manthan1412/air_touch/Schematic Design/Schematic Design link.txt

Website: http://www.schematics.com/editor/kd-46027/
Credential : google account
last Updated : 5/18/2017
