manthan1412/air_touch/Report/abreviatinos.docx

LIST OF ABBREVIATIONS

IMU | Inertial Measurement Unit
AIRtouch | Artificial, Intelligent Remote touch keyboard
USB | Universal Serial Bus
MSP430 | Mixed Signal Processor 430
FSR | Force Sensitive Resister
PCB | Printed Circuit Board
UART | Universal Asynchronous Receive Transmit protocol
PWM | Pulse Width Modulation
TL | Left Thumb
TR | Right Thumb
PLX-DAQ | Parallax Data Acquisition Tool
COM | Communication
CSV | Comma Separated Values
RTC | Real Time Clock
I/O | Input and Output
ASCII | American Standard Code for Information Interchange
RI | Right hand Index finger
RM | Right hand Middle finger
RR | Right hand Ring dinger
RL | Right hand Little finger
LI | Left hand Index finger
LM | Left hand Middle finger
LR | Left hand Ring finger
LL | Left hand Little finger
UL | Upper Layer
ML | Middle Layer
LL | Lower Layer
