manthan1412/air_touch/airType_wordlist.txt

fawn
nunnery
gag
woods
cxsar
spiders
hanging
woody
offendeth
comically
beadsmen
canes
scold
e_
mustachio
mutinies
alphabetic
benvolio
fyodor
slothful
_facilitate_
appropriation
strictest
bringing
wooded
wooden
wednesday
steadfastness
sooty
inevitably
covechous
shock_
sooth
275
sustaining
consenting
279
kodak
snuggled
inanimate
nonsense
errors
cooking
hp
paphos
designing
razeth
shocks
crouch
chins
disobeying
siward
sunbeams
perforations
affiliates
chine
47
perfunctorily
china
affiliated
klausenburgh
boblibindo
natured
kids
climbed
controversy
natures
climber
stringless
ycleped
golden
projection
lengthen
garter
stern
homespuns
nightwork
sternest
dna
catchy
vicegerent
music
therefore
dns
vulcanized
reasserting
swoopstake
sermons
populations
circumstanced
yahoo
primeval
schoolboys
unpack
circumstances
intake
locked
isidore
tinkle
wand
wane
unjust
wann
reignier
disparagement
titanium
callin
want
cookery
absolute
carous
travel
fetters
playback
saskatchewan
canaries
cadence
orspital
halloing
_astronomical_
wrong
sedg
twined
crooking
domed
wronk
gardon
misgives
_immortalize_
welcomed
puling
rewarder
whizzing
_devoid_
rewarded
welcomer
welcomes
fir
wickedly
fit
raggedness
fix
mayst
anticipations
fig
fie
wales
fin
bankrupts
fil
guiled
ostents
corridor
unpeg
vouchers
twits
medline
effects
_verbatim_
sixteen
undeveloped
glutted
troublous
pigrogromitus
bewept
arrow
uninfluenced
_reflection_
burial
telescope
unshak
allah
childer
allan
phoenicians
parasites
currencies
allay
toleration
indiscretion
brutish
gradation
mason
unclog
encourage
adapt
smithfield
outburst
nightdress
strato
abbots
underfoot
strata
corrects
estimate
universally
silent
sys
connive
receipted
ministries
disturbed
portmanteau
whipster
lightened
disfigured
emaciated
reciprocally
maladies
clamorous
olds
revania
service
needer
needed
master
predecessors
genesis
rewards
razorable
enthrall
exulted
cisterns
tokay
swish
mutilated
positively
asaph
idly
regulator
idle
sheen
feeling
longs
politely
spectrum
targe
dozed
erbear
dozen
affairs
wholesome
mostly
hymen
uncouth
toothed
mickle
shipments
committing
diminishing
vexing
venial
mouth
reverence
fluster
expound
singer
singes
unpleas
nettle
affirmatives
tech
purged
saying
tempter
padded
fennel
ulcer
loiterer
tempted
cheaply
apace
clicked
kerns
extemporal
kinase
neighs
rico
blist
bliss
rick
rich
rice
rica
plate
remotest
_absolutely_
guileful
clumsiness
altogether
affronted
givest
uncleanliness
wishtly
jaguar
nicely
patch
eyelids
boarded
unspoke
clarified
sensitivity
norways
advisedly
lots
irs
lott
xvi
droven
exhalation
ira
irc
ire
requisites
discipline
extend
nature
meddlin
lapping
embracement
extent
accessed
tyranny
sparta
heating
incense
perigouna
lookin
southeastern
mortified
assur
gypsies
cult
charnel
humming
assum
godhead
_style_
union
fri
fro
studious
finsbury
muck
much
chink
fry
tallest
cub
retrospect
spit
freehold
davy
dave
doubts
spin
skilfully
misconstrues
administrative
contingencies
crupper
employ
divineness
groats
superserviceable
ternate
prostrate
reunion
overta
verges
ield
disprov
jacksauce
eighteen
principal_
bricklayer
memorial
malefactors
honi
split
visitations
freeness
supped
boiled
marches
frenchmen
qualifications
workforce
sicilians
consents
boiler
supper
untirable
dolabella
canzonet
peremptory
academic
stillness
euphronius
1672
corporate
bellow
maketh
outlives
prognosticate
brandish
endue
hal
ham
trinculo
had
advancement
hag
hay
beloved
endur
hap
has
hat
preciously
municipal
elders
confection
online
continuantly
clustered
shadow
flotsam
joineth
boundeth
nicaria
asmath
alice
festivities
unreprievable
gads
effusion
attorney
disks
crowd
czech
scathe
crown
postmaster
captive
tooked
perchance
repudiating
bottom
inhuman
plucked
appletart
plucker
yelpin
pharaoh
considerin
herrin
starring
filaments
disdains
obsque
stoker
bencher
benches
aden
marshall
bullcalf
bulgar
administer
beings
swelter
shoots
despised
fabric
suffice
boileau
tame
grasping
despises
despiser
greatness
rapes
contusions
alexandrian
ubique
perfumer
perfumes
waistcoat
thesaurus
cumea
verde
perfumed
safeguard
congratulations
humbled
rippling
changelessness
humbler
humbles
nicest
soldering
duer
dues
passenger
disgrace
marullus
extenuated
unnerve
extenuates
moderns
leviathans
signification
paperwork
sympathy
supplier
tasimeter
crowns
role
tamely
vegetative
roll
hawken
intend
palms
palmy
transported
comely
intent
smelling
variable
gamboys
overturned
gown
cincinnati
chain
whoever
machination
osr
ost
osw
coude
chair
irrecoverable
entendre
ballet
impressive
grapples
freelance
crates
crater
oversight
tenacious
downloading
olympus
choice
metamorphoses
embark
gloomy
stays
glooms
pranced
exact
minute
hipparchus
cooks
reining
islets
continuate
shylock
unmix
meadow
hindered
lengthened
chopping
shirts
adorns
kindliness
headset
antwerp
celebrated
300
geography
celebrates
drafted
climbs
honour
plucking
addrest
address
dwindling
convertite
blunter
enroll
reciterai
fledge
dusty
cette
packthread
queue
accomplished
influx
abash
betraying
eglantine
abase
undergone
opposer
working
untaught
hcl_
ergalled
sisterly
vigour
opposed
pavilions
dampness
roland
ittin
approving
thompson
consoles
avaunt
riders
moulten
originally
abortion
harmonious
following
admired
mirrors
locks
outhouses
rivage
admirer
fosset
feof
listens
charneco
vainly
haarlem
thanking
nicanor
kneller
meddler
behowls
questrists
ossian
brainless
egotistical
temperate
surfing
mangy
conscious
puller
pullet
thunders
mango
auger
skirmish
wolves
pulled
salmons
quarreller
feedin
webpage
years
professors
yearn
calydon
quarrelled
jig
unprizable
infirmities
jim
troubles
troubler
horsebacking
antipathy
suspension
troubled
rousillon
apron
_your
recipients
civilian
murrion
bashful
courageously
indigenous
overpowering
drilling
sorted
plung
deads
dido
didn
_you_
azote
fisherman
quarter
seldom
clack
retrieve
bursting
amamon
presages
receipt
frames
irremediable
entering
salads
disasters
learnings
unsaleable
presageth
_archbishop_
seriously
trauma
subtile
internet
macedon
plotting
curbs
incentives
revengingly
inwardly
ontario
deliver
byte
thatching
workmanship
modest
initiate
marls
hames
aboard
stableness
marly
draggin
subduements
neglect
emotion
saving
spoken
reprisal
one
erparted
ony
spokes
ons
affords
stifles
penitence
stifled
embalming
lingering
shawl
surges
tombstones
snatch
herds
absorbs
eneid
rehab
unburied
_compacted_
wandering
illness
sumptuous
turned
locations
jewels
balsam
uninterrupted
_crater_
turner
borough
erudition
invite
betideth
baggage
warriors
sankar
unsquar
zoo
intends
portents
europeans
printer
opposite
buffer
discerning
buffet
staineth
printed
sainted
knowingly
huns
swingers
etruria
lydia
jewry
fascinated
buriest
sovereignest
delphos
friction
counterpoints
heeding
aggressive
imagined
unpractical
intelligencing
hindmost
guarded
rejoiced
tilting
_aigre_
rejoices
awaiting
perspicacity
pickers
keenly
epistles
seeting
recurred
carrion
recoiling
tike
vision
mountant
enthralled
audaciously
whoremasterly
undescried
impressions
hastened
bodiless
refreshes
dexter
impartment
alarming
avails
dismemberment
moons
satiety
enjoys
playhouse
garde
distrain
marrowless
annexing
punto
braggarts
awards
distrait
concentrated
circumference
majestically
penitently
hearsed
rhodes
1720
paring
s
goodliest
candlestick
expended
recordings
allowance
compels
glutinous
_cornishman_
gaiety
compell
_steer_
buoyancy
practiser
practises
webshots
leander
west
practised
motives
challis
wants
vomits
formed
readings
photos
tightened
abject
extant
former
runnin
scath
scarlet
pretence
provost
squeezes
butchers
nutritional
squeezed
situation
scatt
penthouse
mutineers
engaged
organizational
limping
nevils
ascii
verified
pothecary
gelding
inscrib
wires
edged
assigns
sickness
defy
warkworth
edges
wired
advertisement
_aqueous_
vitement
shelterless
nothin
dimension
persistently
adoring
being
disconcert
interrupt
steamer
rover
plumbing
grounded
kirk
dicke
plumed
dicky
overthrow
plumes
dicks
rejoic
unhopefullest
unerring
decomposed
sums
unveil
gestures
summ
traffic
preference
world
postal
decomposes
tremulous
barbermonger
superiority
mienne
militate
unprofited
tombed
obstruct
satisfactory
superintendent
grub
tvs
grup
forehand
diving
divine
saidst
perdie
cavity
overscutch
seaman
measurin
purfleet
restoring
wolds
squabble
averse
leadership
thailand
prepared
hopkins
unmannerly
disabilities
blabs
bewet
_magnetic_
frights
johnston
blabb
perturbed
commingled
speargrass
antidote
ineffably
ineffable
lively
pivot
mongers
rumbled
gleam
glean
mindless
sealed
brazilian
punished
bubble
_anything_
continents
wits
conclud
polnevas
foreheads
witb
with
abused
pull
rush
ragg
rage
tripe
rags
hooal
dirty
abuser
abuses
trips
rust
neglectingly
bedabbled
watches
watcher
ensuing
mutineer
watched
tremble
childed
cream
sayest
yoga
cooked
ascertained
sympathetically
puppy
1449
indemnify
razing
alban
waving
intimation
brotherhood
infirmity
thorn
evenin
maliciously
dissentious
dyed
thort
initiating
dyer
curate
consciences
chimurcho
caused
beware
ceramic
ersized
importune
petherick
hyrcanian
conceitless
oaths
unsever
riots
countless
midwest
carters
norm
roadway
wayfarers
floated
burgher
24th
rn
sans
ascendeth
sang
sand
sane
small
sank
abbreviated
quicker
199
198
195
194
197
196
pash
tirest
193
healed
past
cuckoldly
burnish
stamping
irreconcil
displays
pass
amplified
quicken
clock
corked
knaws
prevailed
gouty
dracula
gouts
jurist
hewing
dwells
hasn
full
hash
editorial
gregory
diapers
daunted
hast
november
rembrandt
cordelia
experience
mouldy
prior
periodic
cessation
moulds
suave
followed
adidas
reclaimed
uprise
follower
pliny
berwick
coadjutor
silva
attendance
mort
mori
morn
fragrance
graveside
more
door
masculine
initiated
tester
company
corrected
chucks
tested
lameness
doom
leary
vailed
cushes
thickest
knocker
learn
knocked
bogs
meaner
fartuous
cabileros
pulpits
prostration
bonded
huge
respective
hugg
hens
viand
hugh
enlarge
dismissed
unhurt
dotard
hugs
erboard
sprinkle
intended
mender
thickened
disgraced
sympathize
mistempered
mended
maltese
lanka
disgraces
malevolent
_incense_
resemble
twisting
rosebud
basilisco
protestation
bailey
exclusions
replied
wools
uncurse
installed
stylus
resorts
_there
paper
scott
replies
smiling
cheerfulness
roots
saucy
tantalizingly
stricture
hounds
symptoms
shuddering
isaac
sauce
colleague
clefts
gipsy
diffusest
jamrach
weeds
idols
smalus
barefaced
weedy
coursed
denny
courser
courses
sovereignly
piping
shocking
reactions
engendered
begged
numeric
gioucestershire
treasonable
lanthorn
advertisers
operation
slish
impudency
shepherdess
dowsabel
kensington
research
inquirer
denoted
offline
impudence
bedlam
parings
abnormally
awin
daguerre
definition
pairs
constraineth
testament
unblown
purport
brutally
preservation
sequester
narcissus
scuffling
tristful
aven
arlington
cradles
moderately
hallowed
bedridden
saint
benedick
aves
essays
ilium
cradled
peaceably
justly
ainsi
capilet
unlesson
ungrateful
condolences
perfum
dikes
spectatorship
blyme
trevorrick
emirates
graveless
charger
elaborate
inferreth
navigators
insertion
organisations
waft
guarding
jumpeth
servitude
bewasted
blond
odors
veronesa
_knew_
sell
sharps
fermented
seld
extorted
self
also
recognizing
permanency
butterflies
astrea
immeasurable
mends
departmental
singles
coordinate
virus
blunting
outlustres
singled
understands
omaha
seize
sometimes
discomforts
barred
reeleth
barren
recks
barrel
bulletin
ambiguities
planched
exterminate
blended
accommodations
bookings
ascanius
baneful
affin
occupation
indifferency
wrapp
wraps
wrapt
collop
cassette
dilatoriness
removable
protectorship
indifference
columns
lombard
ceasing
sunny
remedy
twill
compass
distraction
devoured
sects
pleasures
bytes
sojourn
goitre
wrecks
storming
insane
delicately
313
activists
unplausive
overboard
presenteth
analog
shower
fullin
thrive
aspicious
untouched
demoniac
deracinate
tion
lass
last
anacreon
opal
connection
unthinking
neanmoins
lash
bell
acted
possets
thrasonical
provok
hetman
belt
surance
subversion
finless
satire
suburbs
proprietor
extravagant
patrolled
gloating
combatants
infect
mildness
moderation
awake
struck
presses
presser
caged
newcastle
budger
budget
admire
33
pressed
_transparent_
31
brawny
lade
agitation
vol
von
binding
vot
vow
vor
wouid
vox
cuisine
starlight
twitchy
erbeat
calculation
waddled
unbashful
flooded
mongrels
nickname
implement
infamous
controlment
mered
clime
belee
recoverable
accusative
sequest
crackled
salve
suffolk
hercules
spinners
christendom
cuffs
lady
andorra
rangers
parents
indonesian
emergency
couple
affaire
wives
abound
wived
unwearied
spine
unbowed
spina
chorus
wildcats
tribes
turvy
methods
acknowledg
unsubstantial
bounce
greener
nereides
novelty
benefit
behave
cygnets
obscures
uncropped
feelings
respite
obscured
novices
deserved
simplify
wrinkles
deserver
deserves
solinus
wrinkled
sepulture
terrorists
intl
noddle
vizaments
contributor
sleepest
chirping
katie
spak
span
harnessed
tasting
gases
bios
smilets
sheepcotes
spar
redoubled
opens
considerably
jacks
hawaiian
solaris
atlantic
carping
stillest
jacka
stigmatic
considerable
intestines
peeped
charmed
_indented_
frush
eddie
maturity
charmer
awestruck
chaf
chad
inkjet
unsafe
haunt
cham
char
chas
chap
diverse
chaw
chat
surveying
engender
idleness
mattock
conceptions
fumitory
revision
livings
sublimation
bianca
perverse
bianco
lang
lane
land
lanc
wafer
lank
scream
fidelicet
beverage
prizer
dawning
treasuries
inkhorn
broaden
agued
unbuttoning
broader
amiss
conservative
agues
amalgamation
lecon
turkish
horsing
narbon
contours
debarred
expeditious
carelessly
indicating
deficit
uploaded
scanter
fingres
scanted
petitions
decorating
minerals
championship
_impregnable_
detested
usband
harbor
whooping
fewer
lombards
forsaketh
lombardy
bleyburg
596
cannibals
mishap
unprofitable
crook
video
quarrelous
unmitigable
victor
sweats
waning
animile
multimedia
sweaty
interrogatories
flowing
obvious
lessons
orleans
_itinerant_
fifteen
unbolted
unwittingly
rehabilitation
headline
survey
derby
maws
mussel
makes
maker
thats
rive
steamers
untangled
outworths
rivo
nibbling
desiring
confidence
faugh
incertain
gregor
untenanted
next
indited
eleven
assuring
sedges
tahoe
forewarning
pencil
babe
stolidly
_exuded_
losin
baby
customer
integrating
clients
larch
joinin
retell
errest
customed
scatter
murmuring
unsearch
process
lock
coolness
rode
promotional
honneur
rods
crispianus
educational
procures
paled
procured
tentatives
resolutes
mightst
intelligent
pales
paler
mpegs
locusts
unmuffles
scytheman
paintball
varied
realized
robot
unguem
houston
holds
thigh
mute
plats
despiseth
directs
perfect
broiling
meantime
thieves
unbounded
choleric
physicians
prosper
prophetess
snaky
snake
alcides
realize
reconstruction
ecstacy
cassibelan
spilling
wharfs
scenic
stablishment
forerunning
disbench
electrically
texas
scorch
glasses
suitors
bump
verily
deficiency
books
witness
likings
manhoods
omnipotent
limousines
trulls
campeius
boutique
frowns
unprepared
apprehends
burke
sauf
ageeanwards
unwieldy
ethiop
greedy
decoct
keswick
forwarded
glistening
mainland
hunks
gallons
could
messaging
suppliance
length
ungravely
repeats
subtilly
clotpoll
1340
backaching
scene
1346
soothing
takest
affliction
scent
ulcerous
relighted
vetoed
incombustible
ordering
sergeant
scullery
foretelling
interests
enforcement
stomach
quarry
_silicious_
devoutly
solon
twon
egregious
roulette
pads
chattels
occupat
act_4
act_5
twos
act_2
act_3
intelligis
false
shrinks
chivalrous
directitude
tonight
twasn
mountainous
dishes
epistrophus
worldwide
manor
petals
cipher
banked
boarish
placement
bred
sorrowest
perceiving
brew
rainbows
amnipotent
dependant
patchery
greenhouse
tapp
putrefying
jay
jaw
quickened
jar
jas
terminal
entities
jam
tape
abyssinia
riding
untellable
gnaws
undivided
stickin
prohibition
molasses
mazzard
wring
gnawn
aer
saracen
comprising
taxes
stuff
ohio
exude
strengthened
allusion
pronoun
lawfully
frame
respites
graph
respited
dungeon
destiny
insulting
nuclear
posse
thoughtlessness
membrane
_look
toner
lawsuit
tented
staring
perfidious
challengers
marts
once_
bristow
doorway
bristol
boyet
cudgel
splitters
knighthoods
conclude
indict
turncoats
stithied
undergraduate
rougher
scanner
mailman
wormwood
aegeon
attainder
genetic
entitle
feather
jaunce
marcellus
forspoke
misguide
hateful
_electric
banish
garrisons
sourly
lecherous
inadvertently
cvs
podcasts
deductible
agonized
stuffing
purchas
aquilon
lascivious
macedonia
impervious
ransom
tattoo
denial
bolder
windham
vocabulary
mainmast
unimaginable
venalia
colts
identity
diabetes
audit
off
audis
indonesia
patterns
fashionable
oft
audio
powd
reefs
newest
hallowmas
_mystery_
clocks
ringtone
web
disannuls
wee
wed
undulating
villagery
wet
practise
villagers
neckcloth
unshout
photo
crum
pied
christom
piec
crux
cruz
zimbabwe
gambling
supping
pier
pies
burgomasters
emma
bulge
ransomed
alencon
hesselwood
flickering
presuppos
become
gaining
incens
underwent
immortal
soothsay
gymnastics
scatters
choosing
flush
hissing
blonde
recognition
collodion
farewells
passion
copulation
biology
routers
pressure
posterity
imaginary
bartholdus
coldly
lifestyle
useth
blackness
ghoorka
swimming
cultivates
letters
sharpness
cultivated
privates
terminated
glistened
splintered
pairing
impieties
watchman
heresy
yrs
yarns
souviendrai
unbid
sextus
tossed
howsome
evident
_nosferatu_
shrunk
ercles
flieth
excitement
placed
burdened
gloated
periwig
proserpina
quarries
nurses
nurser
graphical
hearers
aristotle
nursed
effected
compared
didst
andsome
deadly
lately
saviour
details
behold
beseechers
rebelled
burdenous
repeat
erposting
virgilia
casque
outlets
myrmidon
impregnating
misbegot
argil
repeal
exposure
searches
_copper
mechante
surplice
perpendicularly
compete
polusion
villainous
searched
misheard
gardens
vita
candidatus
linsey
magnetic
_by_
nursery
integrity
stinks
haters
worts
gravelled
neighbours
suum
worth
scriptural
amorous
stud
perishable
aurora
merchantmen
replication
covetings
progression
mauvais
curtal
congreeted
deadline
cms
enwood
jamaica
depraves
sabbath
depraved
professionally
rouen
carper
overweigh
machines
oatcake
misconstrued
unhand
unhang
polydore
richest
poleaxe
equall
protection
ploughed
sorceress
audre
vurther
icons
aialvolio
drinkings
cowish
vapors
empleached
_continued_
bra
sarah
plot
plow
sumptuously
nine
coins
bundles
plod
_respiration_
sweaten
girdling
tryin
sweated
exacts
separated
bombast
plenitude
ascribe
championships
pheeze
yard
adamant
blocking
erpast
1990
1993
kelkoo
erp
1994
err
ers
ere
era
elbow
lucetta
ern
scripting
overspread
indicated
quivering
flung
heartless
impair
indicates
_pastor_
plautus
caterwauling
cautel
recovery
carriers
inhabitants
nuts
grandpre
recovers
resignation
arcu
chines
hong
customs
dumbe
bared
greediness
arch
elusive
ploody
araise
liveth
purging
meeds
unexpressive
wouldst
indubitably
borealis
sibylla
derides
ancients
pandulph
austerity
emselves
drudges
production
valor
fleshed
hibocrates
coffee
typescript
choicest
jerking
safe
vlkoslak
laconically
roommate
heaven
penetration
coffer
jerkins
glanders
changelog
reasonably
routines
l
cullions
reasonable
cashmere
feeds
por
emeralds
distilment
slep
draweth
slew
gladdened
dearth
trainers
sockets
daniel
owning
engrave
confections
fatting
occurs
forcible
barrier
colorless
certifies
dashing
forcibly
detecting
certified
drench
shrubbery
maniac
refugee
flawless
renew
manias
_25
footsteps
clouding
stripling
render
refin
synonymous
crucifixes
hamstring
another
disembark
electronic
illustrate
timothy
dogg
cloquence
approximately
_virgin_
fumble
john
dogs
emblem
alonso
perambulator
wastes
scorpions
wasted
gyves
pella
guild
guile
preformed
guilt
domestics
combustibles
contento
younglings
respecting
portraits
contenta
enchanted
cicatrised
comfrey
etext
contents
praising
convenient
saunder
subjects
pilgrimage
gravy
acquire
lucre
germane
troughs
immediacy
germany
quantitative
enthron
transsexual
conquistadores
grave
enshrines
nostrils
circumvention
dorcas
swamp
bracket
aunt
repudiation
reserve
lewis
dearness
daze
disturbs
slightest
uncurls
geyser
wishlist
industriously
hangings
haunted
jovem
ferryman
runs
wrested
tartly
lexington
rung
mantelshelf
scrubbed
secretary
edited
gladness
mousing
torrents
discussions
optimum
techniques
diffidence
draws
away
transcendentalism
sites
_dot_
bracing
cooperation
awak
drawn
encounters
shields
pastes
kissin
_crusades_
rudimentary
mallows
handful
diest
visited
abolished
kitchen
climate
excrement
disarms
canus
solyman
disappears
householder
tone
planteth
mutations
tons
beggared
infirm
tony
telecommunications
gratitude
noes
quenched
sorrowed
incertainty
spectacled
rustically
attacked
stifle
excite
madhouse
signior
wiving
modicums
armoury
gracious
lictors
reciprocal
gnu
bifold
_economically_
thrash
souse
cons
uganda
beetles
cony
habitable
_could_
tissue
cone
conf
conn
drawers
peopling
survival
plainsong
wheel
fust
fuss
unready
hang
hand
liberties
brisky
fuse
hans
wheer
mil
1609
1608
vermont
whereby
1601
1603
humble
1605
1604
1607
1606
gratulate
mia
client
humbly
sullenly
entwist
musical
_chaos_
bereave
oleander
traditions
edmonton
newton
thanks
ol
hermetical
precipice
extol
electronically
exton
jose
webmasters
yamaha
cornell
hasting
josh
wright
shout
trampled
taleporter
righteous
insensitive
hoists
tricking
lcd
leagu
designers
unmolested
hairless
forres
rustle
tendered
cooler
href
homing
kibes
thrusteth
clegs
cooled
mazes
flatter
briars
born
_christian_
mazed
bore
bora
confusing
ungracious
congratulate
qualmish
asking
zanies
participation
galsworthy
peel
architectural
gordian
peer
peep
canoniz
gentler
gentles
alembic
jauncing
wasting
sparing
profession
beneficial
candlesticks
popingay
auricular
stumble
untempering
hoodwink
deception
lenity
teachest
conservation
boom
mosques
gaseous
overjoyed
diligence
observances
needles
catalyst
emulous
isis
_minuteness_
vagary
crows
afear
ancestral
maximum
hautboys
apostles
heartstrings
mantuan
nervii
clarke
bedrid
prayed
villiago
guesses
request
tenour
mollification
postscript
xiii
expertise
prayer
rawlings
brainford
nosing
thriftless
evasive
unseduc
pichunter
dynasties
update
mulmutius
_particle_
deposing
gobbo
bed_
berattle
preoccupation
outdar
interval
beds
ebon
banquets
antres
songs
concept
horseback
supplement
battle
amplest
tenable
layers
soothed
varnish
unnumb
drunkards
gigs
dissatisfied
soothes
eliads
temporiz
demurred
automobiles
gatories
gud
turns
gui
gun
gum
gul
ravenspurgh
evades
guv
gut
edicts
hymenaeus
slopes
geek
ensteep
cost
larums
barbie
heaviness
shares
shared
oaks
supposest
_cum
efficacious
royalize
vaward
fantasticoes
lustrous
combatant
sieve
teaches
teacher
sociable
sending
plotter
generator
sparks
lastin
franklin
equable
shaked
pillow
filches
lighthouses
inly
extra
polacks
enschedul
f3
wraths
fbi
quenching
disguising
betsy
caskets
coziers
mummer
captivate
unctuous
wonderfully
valium
slough
intently
cluck
sanctimony
stanley
restlessness
fumbled
ibm
defeats
fortified
prepar
tranc
purge
dyin
woefully
trans
fortifies
vater
cinna
gales
chip
rushed
galen
seemers
occur
chid
crimeless
allots
discussion
spreads
lounge
varnished
_capacity_
strays
retorted
economy
armies
product
peerless
martius
apelles
produce
noses
kurt
conquests
acquaintanceship
approx
serving
ender
freckles
approv
soc
ended
stile
tablets
_astronomer_
still
freckled
lyin
spacious
saxon
atonement
correspondence
non
sweno
nod
noe
thermometers
nob
sol
wealthy
not
charring
polemon
nor
nos
placate
sop
contendon
drop
increaseth
pommel
unloaded
sot
yead
nutriment
prompted
challenged
_appropriated_
stooping
yeah
challenges
challenger
prompter
yeas
year
naming
philostrate
tried
furthermore
thirst
tanquam
_symbolical_
calpurnia
advantaged
odoriferous
ibat
diagnostic
advantages
appealingly
buildeth
semblably
contemplation
transition
scarre
sewin
fc
tangled
invitation
thankfulness
fd
outcry
altitude
semblable
smelting
blind
romania
solicitors
nazarite
blink
consecrate
pliant
fi
rind
ring
tomorrow
constructing
videlicet
comagene
thankless
remotely
typographical
wordpress
scamels
grandame
fleshly
larks
sorer
sores
colted
repossess
prometheus
sickliness
sorel
oneyers
appreciated
greenwood
_utility_
artificer
transferred
cockle
vocals
apples
cymbals
estridges
extinguish
grooms
profuse
syracusians
enhanced
overnight
_acrid_
spurting
windsor
snorting
tombless
taliesen
snout
equipment
awaits
beholdest
inrushing
mountaineer
neatly
parle
importantly
america
respice
steads
attempting
implications
mrs
farinaceous
cogscomb
discoverer
chicks
spyware
discovered
beech
canons
beseems
inventorially
stair
embittered
distaff
staid
preternatural
enriched
stain
shrill
interstate
whiles
teniers
bramble
stroll
blate
sorrowfully
ostade
_blanched_
ploughmen
ambling
baits
hungerford
unwares
burst
anchored
actively
bodykins
welshmen
separately
foppery
suspects
glaze
refts
_luxuriant_
colours
gazette
import
cardiovascular
tonquin
heureux
caricaturists
nointed
quondam
aguecheek
hurts
plating_
broil
_tenacious_
stouter
yorick
resides
nill
depeche
nile
resided
haunch
impediments
madness
harbouring
pestilent
foreboding
jeans
inexplicable
exploit
bedouin
merriest
jeweller
brats
muttered
lioness
coleridge
156
tropical
dictator
158
impugn
krone
straying
monsieur
elvis
midwives
suspected
baying
aery
scut
hardiest
winks
scum
cherub
implacable
bevis
raptures
beaver
waterway
develop
inquire
pester
quagmire
transcribing
inquiry
contortions
unlace
enigmatical
foal
foam
instigations
unasked
howsoe
_commercial_
demean
electrotyping
taxi
livestock
decerns
neon
procrastinated
sweeping
growled
maternity
greetings
stolest
disburdened
death
unwooed
euros
pettish
guessing
volubility
verse
versa
disputing
caelo
swim
propped
psi
exult
stung
amd
salutations
amy
earnest
permanence
using
psp
headpiece
pst
fortuna
learnedly
fortune
cheerily
wisdoms
annually
yedward
blackberry
_pungent_
twelve
falsehood
verbal
apartments
undistinguishable
tragedies
1858
1859
regina
unlocked
1853
1854
1856
1857
garret
assembly
sixth
punched
innocency
burthens
innocence
sixty
francis
creaking
piety
devon
conceals
palma
backup
peaces
freeing
outlook
mouthpiece
kindlier
masterdom
shrinking
intervention
stare
shags
qualifying
stark
start
starv
ignomy
stars
starr
politeness
undeck
pitcher
delayed
philosophers
recoil
enfranched
pitched
deceptious
fraud
embedded
intermission
bessy
phosphorescent
vacantly
loneliness
drachmas
mercuries
intents
600
pillicock
macbeth
decreas
sheath
prescripts
riggish
cabinets
appraising
trample
terminating
_instrumental_
fools
forcing
correggio
poor
poop
phys
diaries
whistling
apoth
insomuch
vp
registry
queensland
pooh
pool
loyally
awed
corea
roisting
moonlight
deary
trumpeters
prying
townsmen
overseas
jesters
monte
myst
ceases
espies
month
unrest
thoughtful
clinquant
religious
conger
corps
wealsmen
unenforceability
pledged
wyoming
congee
fountain
wma
pledges
resounding
chiron
horror
coloured
decide
valiantness
begot
ergrown
msie
holloaing
throbbing
ass
lulls
ottomites
streets
heralds
lulla
cestern
befriends
jointing
hamper
inert
braggards
actaeon
cues
adieus
investing
dirt
lurch
steadying
bestrid
scenting
learned
pioners
scoffing
dung
iwis
tracks
bribes
plessed
marring
belize
loadstone
blithild
conviction
inspired
losses
indirection
advertising
_all_
sealing
successors
inherits
requiring
ask
sbjct
seventeenth
dowager
conventional
revelation
enjealous
doreus
asn
chaotic
pur
serpigo
acacias
brunswick
blewett
lowering
unlearned
grimly
lazars
musingly
deigned
daymark
pretense
followin
peised
grill
unyoke
cleaving
evitate
hermione
byers
phrase
cuppele
utilize
surpassed
unlucky
shrouds
reject
vigilance
unavoided
argal
communicating
purring
_not_
productivity
horizontal
diabolically
_note
corrupting
_nota
bastions
travis
anytime
daggers
roommates
_pourparlers_
photoshop
remnants
basename
charities
thermal
comfortless
herod
wishful
mites
bechanc
absence
systems
differed
rabble
pavin
catalonia
dirges
pleads
curtis
worthier
musket
petted
cet
ces
petter
worthied
bryan
unmerciful
fairs
disdaining
blest
fairy
whirr
heavy
transcribe
restless
jaws
circumcised
exasperated
defibrinate
punitive
footboy
exasperates
advocation
unskilfully
wedlock
malcontents
testify
jolly
engrossing
safety
7
shrivel
appertaining
earns
housed
toiling
livelong
reliances
houses
unsightly
brightest
straightened
hapless
loads
housewifery
americas
american
_flexible_
zoophyte
_later
melteth
faciant
craps
effortless
visions
telamon
horse
blossom
rummiest
announcements
station
seafaring
trails
brocas
hundred
merciless
vincere
whetstone
1918
basan
risks
tft
consonant
montjoy
tapestries
grew
indrawn
miseries
grey
hesitating
gree
greg
valorously
4557
toward
charlotte
footnote
todten
heaviest
aussi
greybeards
blissful
antonio
organs
boorish
cave
flibbertigibbet
unconstrained
aired
jamie
accoutred
chatillon
hired
hiren
_high
wreckage
flatters
moonshine
tongs
velasquez
tongu
convertest
unwed
physics
ennoble
phenomenon
hovered
referr
padstow
velvets
velvety
heavens
albums
perfumers
distressing
champains
justice
_expounded_
harmed
wholeman
hallooing
dotant
retorts
grocery
strut
feels
harwich
westborough
pretending
competing
boils
imitating
indignations
unfurnish
boost
expedia
adhering
stored
howled
locale
xxiii
culture
howlet
mediators
close
pictures
_alembic_
rancors
_similar_
thongs
blunted
pictured
stagnation
ranker
missing
zipped
conjoin
sprag
idolatrous
lifteth
arrears
sprat
hoisted
versing
undetermin
forgotten
vault
experimental
unfolded
signiories
surnam
scathful
threaten
empty
lived
ada
modelling
tremulously
lives
liver
ado
furrow
pact
intriguing
zodiacs
pace
exuding
ought
guido
astraea
guide
sombre
pack
costly
banqueted
embroidered
petar
albany
nutmegs
clepeth
grant
albans
pearlash
uncasing
sensual
dictu_
grand
settlest
composition
anticly
valances
fatty
ratings
wanteth
blair
soberly
000
klausenburg
mellowing
vitriol
gamesome
batler
obviously
aflutter
synopsis
crispin
speculative
reverbs
exploits
bearer
transference
shivering
settlements
reviewed
mahony
reviewer
petticoats
supersubtle
etceteras
cherries
questioned
rejoiceth
operators
sworder
showing
dubai
ruff
dearly
preparatory
ponds
thews
quietude
excluding
baseness
eel
affecteth
popular
softness
adulterous
sketch
caspian
markman
furbish
coney
lipp
lips
economic
lusted
beuk
dilapidated
spouting
grissel
competitions
confounds
trotters
plebs
squirrel
benefactor
opposes
assists
owever
negatives
_decorating_
smothered
handbags
ghosted
papua
perished
silence
unimpaired
debateth
subaru
alpha
carnations
bangladesh
visag
placing
_sara_
withholding
masturbation
healthful
_costly_
mulberry
sick
injection
aftest
vacancies
limpid
politic
partlet
tymbria
rowland
clothair
scratched
broadened
ordered
interventions
varrius
accessibility
reopening
indrench
surmise
ancestors
amounts
dashed
fears
application
clamours
department
aprons
manhattan
dashes
smiles
venerable
clean
assimilation
smiled
invitis
divinest
skein
e
trueborn
evilly
resolving
orbit
membranes
bribe
ignorant
aesculapius
hurricane
emboss
compact
birthplace
intemperance
vesuvius
stunned
margent
giantess
friendly
pdas
wave
felicity
rattling
telling
yourselves
nausea
mauritania
positions
compassionate
michael
watered
ryan
unexpressed
cloister
peseech
enforce
muffl
dotage
thinly
jump
notwithstanding
clangor
vsnet
vampire
stockbridge
houseful
sportive
fifteenth
pancake
becom
detached
convert
convers
_beta_
gent
climature
gens
avaricious
gene
salvation
patents
interstice
foresee
transformations
clark
revok
manage
clara
nilus
infest
_indestructible_
camera
andpholus
wakest
brundusium
subsection
grumio
formally
visibility
charming
gauls
appointed
contumeliously
stafford
meek
perceiv
meed
lapse
recountments
insinuateth
servants
meet
ribbed
votre
blains
links
proxy
pulling
sought
lamentings
lenore
embodiment
defective
despairs
spightfully
ligarius
waterproof
ordinaries
sentiments
dissolv
volant
instinctively
embellished
fare
farg
fouler
farm
ronald
fouled
simpcox
ratsbane
introduced
knowledgestorm
marquand
overmastered
scoop
prays
encyclopedia
ermaster
favourites
amaking
_alchemy_
epigram
including
costume
singulariter
abjur
shafalus
equanimity
thence
temporal
lithuania
walnut
moneybag
ridiculously
vancouver
turfy
stoup
stout
unnaturalness
university
slide
overcharged
somewhither
discords
prevailing
congenitally
quivered
weepingly
maugre
constitute
portcullis
separating
special
cousinly
entertainment
armor
discharg
fagots
cause
stews
tully
pharmacopoeia
masham
bleaching
darkly
jill
levitra
costard
sneer
delegated
resumed
curtainless
galling
timer
times
resumes
humphrey
outrunning
indigested
leonora
crams
powerful
seventeen
gruesome
flidge
warcraft
bitch
wrapper
ankle
fairest
mariana
curstness
usurpers
spited
lists
manufactories
chemicals
spites
secci
485th
bloat
girdle
submitted
telecharger
sumpter
insignificance
speakest
unneighbourly
julian
sv
horrors
environments
enforces
metaphysics
bastard
lirra
savory
bladed
battles
mordake
relatives
horrider
battled
blades
venereal
subsisting
discov
sc
vengeance
gallery
indu
urg
inds
url
overmuch
urn
uri
brevis
inde
urw
elysium
urs
gest
constrain
wilful
halting
cartilages
ottoman
obsequious
tiller
sheriff
cicely
brighten
receptors
hector
inherited
achieve
ayez
alabaster
maritime
durst
dwellings
tobacco
imperious
episodes
ruminative
tuned
coaxed
flit
tunes
tuner
grams
widow
multiplying
outbraves
shrouded
canine
operates
horrify
officials
marchioness
operated
lord_
luckiest
southwark
nightmare
illusory
southward
tend
unshaven
tyre
tens
direst
tent
ken
kem
tripadvisor
plenteous
hurrying
avid
swearers
interfere
strumpets
magi
merry
kep
aslant
hits
sniff
limits
shingle
monstrously
strains
refraction
estimation
tuesday
presaging
plessing
jimmy
choplogic
accomplishing
outcroppings
renewest
riband
cent
outlaws
immense
versal
preambulate
heigh
battlements
pontus
controlled
bewhored
multipotent
controller
fearest
garmin
debtor
mudded
noiselessly
emotional
poysam
censurers
examines
modestly
scrippage
simony
surface
thebes
hearten
fitzwater
hearted
cometh
dawson
welcom
zoophytes
parti
_volatilized_
suspire
proceeds
parts
speaker
northwest
party
maidenly
http
huntsman
abounds
colouring
steals
destruction
rift
scarcely
ashley
prater
ptolemaic
weblog
drowns
advertiser
crimsons
discord
increasingly
42
slunk
liked
43
distant
advertised
hest
parchment
vindicative
flaxman
oeillades
density
cullion
trerumpford
bourdeaux
emblems
riverside
indignation
disappearance
howto
propelled
bottoms
intersection
loss
lincoln
necessary
lost
rots
payments
lose
parching
disponge
rote
revisits
glare
gauntlets
library
homo
leers
home
scales
steaming
broad
objected
grinding
cradle
mutation
adventuring
fanny
demonstrated
limitations
hurly
reaching
cumean
archidamus
ravishments
pulpy
refuge
cataracts
tonics
unhinged
pleines
anchorage
pistols
erween
previously
tortur
_inferior_
cocoa
trackback
honduras
tabernacle
paned
additional
inconstancy
_pastoral_
metellus
captainship
growths
north
triangular
fountains
gait
admonish
strawberries
gain
wince
sprinkling
winch
highest
minutely
displac
_supposed_
annexment
display
urging
sponsor
marketplace
_short
universal
kisses
beats
kissed
functions
germains
ingredients
unreconciled
finch
recklessly
troll
stat
star
foix
fois
stay
foin
stag
foil
stab
additionally
stan
else
phosphorus
shuns
samsung
fertilize
indirectly
shunn
aided
forgone
knelt
nottingham
astray
perverted
trodden
consists
sashes
unfeeling
rechate
aug
swam
swan
disability
pensions
sinew
painters
aus
bays
sinel
aut
offending
sorry
sway
fists
_me_
cavaliers
rushling
atwain
voic
logwood
confederate
bowstring
prattler
astral
crops
cropp
boitier
herbert
_mem
answerest
enhance
chemically
whirlwind
reproves
likely
causeless
pindar
spoonful
subordinate
amphimacus
snares
favouredly
spokesman
unwholesome
propre
reviving
convented
med
meg
mem
join
mockwater
men
met
mew
nicht
paso
mes
dunsmore
contraction
suppler
oozes
alchemist
bumps
chrysler
complicated
matchless
joshua
fantastic
baptista
slices
guests
jackets
_face
subtractors
tertiary
spaniards
_preposterous_
survive
virginius
tenacity
scelerisque
_vinous_
berlin
hindoos
jpg
marle
yoketh
rook
room
trots
rood
roof
movies
holdfast
exceptions
perdita
troth
gettin
purgative
skype
compremises
bellman
foods
eltham
wanderers
shelving
titular
colds
amazing
confin
blackish
remonstrated
banbury
wallpapers
blanks
arrearages
manuals
pausingly
loyalty
cowardship
third
defacer
descends
defaced
meekness
operate
athletes
680
calaminaris
determinate
compunctious
nostra
fable
budding
before
erteemed
neatness
deathly
personal
pius
crew
sprays
returneth
malapert
confidently
equinoctial
combination
caterpillar
promis
glazed
imprisoning
downright
eyas
_ingredient_
untun
arrested
lazar
styga
ducking
harried
wodin
lofty
calmly
mumpin
durability
weightless
skins
harpier
trading
forgot
aids
besmear
_sophia_
postman
merchants
unbound
redressed
lurks
redresses
ont
venezuela
gelded
foto
resume
ascending
abate
stomachers
apostrophas
acquittance
trebles
punctuated
investment
trebled
vouchsafing
penury
enraged
oracles
lettuce
warped
enrages
immensely
praxiteles
rashness
acquaint
84116
hawks
fiction_
consistent
reprobate
digt
fancying
digs
requisite
digg
sicilius
begins
whetting
kingstead
evaporates
bitterness
murthering
creekuk
batavia
knights
hailstones
cavaleiro
tattling
pique
palace
rattle
reassert
ginger
clouts
theology
tells
unfasten
sleeped
busky
adamantine
harrows
_roller
communicative
launceston
triumphers
fitting
scaped
sleeper
mario
steinkoff
marie
maria
servitor
statelier
observation
impostor
shriv
slaughterous
breather
competitors
breathed
paysan
scotch
bedclothes
aquatic
alcibiades
probe
dependences
kruger
flouted
trappers
_true_
liberty
specialists
northeast
cumberland
bookish
dissolute
bermondsey
centurion
_fibrous_
abrook
chalic
nubia
bootless
christopher
pallets
saturn
earl
earn
traverses
eard
copatain
godliness
crusty
reload
monumental
traversed
troop
yelping
eart
erwhelm
enchant
terminology
ears
imitate
testing
alterations
blameless
allure
interruptions
artificial
adjudged
wears
ome
weary
vernon
recruiting
cousin
motto
suggested
_architectural_
resistant
scantling
uncertainty
metaphysician
russia
sweepers
_hair_
aspics
supports
guaranteed
incessant
lanterns
phillpotts
mannish
accustom
tint
tins
puts
basis
regenerate
patrolling
parsley
tiny
cyrus
ting
commission
trigger
remediate
interest
basic
basil
entered
lovely
deeper
perlite
dismiss
lionel
monachum
tudor
affirm
hideously
spontaneously
ugly
distemperature
unshed
pessimistic
seven
cane
discredits
recuperate
cank
fullers
_telegram
inscrutable
sever
fatherless
parish
realizing
billeted
meetup
colonies
outstretch
bearded
dommelton
leaven
elle
undaunted
unicorn
weakly
programs
failing
inherit
leaved
approbation
bene_
801
800
investments
hujus
cursorary
mockeries
neighing
yea
downwards
agog
kinks
poniards
assigned
fighters
reformation
yes
yer
squele
yew
1774
1777
1776
canstick
pecuniary
royal
goodman
handshakes
appellant
copyrights
save
woful
trimming
boasted
sailors
reviewest
supervisors
discreet
shyme
honfoglalas
ramparts
bergomask
tormentors
testern
allhallowmas
foredoomed
cowardice
greenland
dean
deal
deaf
maxim
dead
vaulted
fingering
whatsome
dear
translates
dowle
donne
carts
cleomenes
chimley
subdu
jackanapes
provoking
thinkest
exeunt
_causes_
subscriptions
sprighted
milksops
missive
wept
mamaliga
barbarians
blithe
jenifer
fleshmonger
automatically
ores
managers
paunch
missus
down
fumes
scalded
thinned
narration
cardiff
refined
unregarded
murderers
tennis
jealousy
corporeal
soma
editor
fraction
factions
starve
appositeness
clinics
batman
landing
pierre
feminine
prettily
imbibing
loveday
assented
sprigs
prevents
engraft
rageth
average
strengthening
lammastide
petit
graff
unhack
tarnished
rouge
muffins
awhile
addle
thund
graft
courtesan
marking
fidele
leafless
answerable
manakin
erflows
snowdrops
holly
roomier
faction
extremest
utilities
unwell
journey
brightens
budded
magnificence
weekend
happening
shallowly
restores
pseudo
jacket
stripping
profits
discreetly
relieve
princox
vermilion
advantageable
holidame
coastguards
idolatry
commentaries
retention
anticipation
disorders
swoon
father
0
reptiles
swoop
sovereignty
erlooking
considerings
advises
strumpeted
greeing
_impartially_
defying
advised
stiffen
_solution_
proposals
noiseless
unquietness
round
clitus
talked
dealing
measurable
asham
talker
ravenous
targets
heroical
laundress
romish
encrusted
fillet
tewksbury
intelligencer
annals
suspect
unmounted
international
covetousness
filled
engrossments
dwarf
loathly
lakes
palpitating
grenada
wearily
rebates
box
boy
thinkst
sphered
crayons
bor
bow
mortis
spheres
diagnosed
bon
bob
fowling
bog
recounting
insolent
statewide
discontenting
merely
discontentedly
uncorrupted
vergers
mucilaginous
unagreeable
sweating
sake
lieutenants
stoops
visit
vineyard
olympian
aries
dolphin
labyrinth
osprey
bushels
dragg
gadgets
_mechanical_
extolment
tracing
making
thicknesses
nearest
immortalize
flouting
sample
unavailingness
unhandled
dennis
subconsciously
idn
burgeoning
forslow
benignly
tearin
artire
persuasion
146
ceremony
144
145
142
143
140
141
148
149
revoke
membership
mocks
spoonfuls
ide
noun
waist
reseller
purify
monde
oaten
basket
nous
bungle
serge
shoes
northampton
leafage
thunderstroke
concolinel
fatalities
solder
peterson
blooded
outbrave
group
monitor
interesting
tillage
policy
sterility
kidderminster
tucked
rattled
berruguete
tucker
lunch
squand
discoloured
leopards
teller
feverish
voyeurweb
thymus
bedash
promulgate
leda
_artificer_
careless
brews
elephants
unbarb
treacherous
continu
manifests
unclasp
_lyric_
carlisle
stitch
effectless
reputeless
condemns
pamela
insecure
assurance
romano
_prime
romans
ajax
varna
ajar
romany
carnival
waiter
contented
funky
registrar
invalidity
assuredly
remorseful
first
fleeing
dungeons
rachel
subterfuges
rachet
bridegrooms
fourscore
urbino
ingener
moisture
returns
speaking
gaudy
flagstones
streaked
memo
bobb
crevice
confesseth
piercingly
_evaporated_
goddesses
mistresses
scraping
dolour
centigrade
proofread
inferring
lick
pittikins
overflowed
shovelful
entombed
sizzle
pastry
kevin
cassandra
squat
squar
unsoil
vestments
foreigner
shocked
acumen
squad
_hillingham
interior
performance
jungle
flattered
tenantless
203
202
205
204
207
comings
arguing
cathedrals
incidence
allayments
rehearsal
aloud
assault
nostrum
sheets
billow
complaints
_obstacles_
tugging
beth
queens
harlem
bleating
lacies
scowl
harvey
sigma
skilfulness
reef
supposition
curdied
bedside
_english_
disunite
threshold
sponsorship
takin
despairingly
stormy
treasure
storms
spirituality
stand
travesty
treasury
admixture
enthusiasm
awareness
info
dishonourable
get
refreshed
unimportant
hailed
unconsciously
slily
dewing
geo
gen
gem
gel
ovidius
seared
bearings
colossus
morning
miles
nostril
gammon
tallow
declared
erflow
seas
sear
unkinglike
menac
seat
declares
seam
seal
marquess
insoluble
menas
wonder
indicted
satisfying
sea_
label
boundaries
enough
vindictively
smooths
satiate
infrastructure
august
dreamless
pisky
nationality
gauntlet
coupons
stitched
vaporous
recitation
blasts
tour
tous
tout
cognizance
guardians
among
unthrifts
_orator_
unthrifty
spann
spank
uncouple
spans
considering
tuning
clust
capable
repine
peruvian
judging
doubleness
tercel
dramatis
derogation
precautions
lustily
streching
worsteds
squash
laptops
dramatic
wake
declaration
roguish
clept
deceivest
sound
bullocks
ariosto
_converging_
1100
forefinger
cancelled
seethe
antony
cock
ulysses
trothed
strait
sleeping
strain
sudden
loosing
protein
_facio_
creaks
unskillful
dairies
lave
creaky
woodland
willeth
lava
clammy
workplace
interweaving
extended
patrician
affeer
assist
hullo
tragedian
companion
doublets
annulled
rimed
ruffling
businesslike
lequel
objection
admonishing
roebling
consisted
yearly
phidias
stoutest
sights
epitheton
pissing
flavor
statesmen
very_
pomfret
forgo
proclaimeth
nav
swooning
nuther
tenses
voltemand
gnarled
perceiveth
credentials
viewpicture
acquainted
adams
zenelophon
identifying
tromperies
twittered
marmoset
yokefellow
overshines
bewitched
passionate
afflict
aristophanes
prerogatived
pronounce
images
snoring
smarting
herald
gladder
calculating
drenched
footing
_odoriferous_
gladded
husbandman
knife
caring
kansas
dray
fitness
unbloodied
pockets
partizan
fallacy
syndication
cautions
dividable
fertile
fettering
coupon
skilled
harness
skillet
pastures
grafters
acquiesced
paraphernalia
distracted
restrained
pastured
erweighs
motherly
shroud
laine
spice
_satellites_
prototype
arranged
vhs
gremio
eschew
powerless
railed
glozes
bluecaps
giantlike
censor
imagination
examine
clenched
toaze
_confidence_
casualty
again
strikers
gbnewby
weeded
sweethearting
ungain
whippers
weeder
fangless
unthinkingly
troyan
nuthook
carnarvonshire
_isolated_
epidamnum
itches
sequent
grudge
assets
misadventur
burrow
u
langues
bepray
colleges
lapped
founder
allergy
founded
expressions
desdemona
plodding
shattered
preserves
preserver
anglais
immanuel
gp
preserved
crimson
enjoying
puffs
sitting
vinegars
uphoarded
toss
jeshu
newly
washing
catherine
drugged
_heat_
alms
drugget
tribal
outfac
outworn
reputing
clinch
straighten
strung
zero
perspective
plugins
affable
creatures
residue
repeals
sweetly
swamps
wrecked
carcass
displeas
morrhage
rers
basely
mull
intrench
dareful
blubb
mule
newspaper
threads
affectionately
furlongs
_argillaceous_
jutty
oldin
bestirr
displeasures
medico
carcase
steerage
medice
significantly
repaying
misery
misers
troiluses
africa
_terrific_
shareholders
composure
governance
squires
paterson
hyrcan
plasterer
desir
handsomely
mozilla
constructs
jangling
apprehensions
grisly
karaoke
leisures
hour
hous
recall
phrasing
sucks
scrooping
guards
remain
halts
dazed
specialized
reaps
_crevice_
stubborn
bluffly
onslaught
minimus
collision
minimum
numbers
robinson
biography
homicide
pence
needs
needy
technology
comfort
gladding
maps
mapp
thaws
stir
needn
noyance
kitty
divinities
breasted
questioning
coming
licio
tyking
paragons
dragon
mislead
skilful
firelight
rand
wiring
through
hundredth
fissure
pcs
staithes
bosom
boson
researcher
holmedon
pci
unswear
attractions
impressiveness
pancackes
pesth
homicidal
smothering
prejudices
encouraging
tinned
compound
prejudiced
attending
_ooze_
viewers
groped
mystery
restrict
huddle
divested
evade
asparagus
namibia
_surf_
repeating
tiffany
winnow
engaging
katrina
excrescence
suspecting
tameness
taciturnity
caloric
deft
portentous
evaluation
borgo
henceforward
vendible
extraordinary
impeached
backed
beginning
flourisheth
needing
congealment
primy
withes
wither
configurations
indebted
embraces
enkindled
_is_
stabs
exchang
breathers
embraced
stabb
heights
stabi
unacquainted
razor
bloodied
slanderers
hollows
bloodier
sated
combats
ordure
tom
trolly
scantily
differentiate
prodigious
unpardonable
unkiss
monger
subornation
unbroken
dacians
swerve
pible
urban
ditches
cardmaker
showers
graphite
blanch
merrymakings
depending
blanca
couch
lifts
rafters
kendal
chary
godfather
harbingers
programmers
amities
eggs
erpeer
chart
rushy
advert
stockish
charm
services
chernosese
chare
charg
teems
sibyl
feasting
unsealed
focussing
sepulchre
seething
reflections
pease
consanguineous
rebels
commissions
noblest
converge
businesses
curvets
rebell
postcards
refusals
exteriors
chimes
merger
idiots
approachers
plaited
volatile
merged
biddy
unus
express
bitterish
menelaus
breast
cholers
tournaments
motorcycles
unlook
_round
latex
dante
doubled
witches
doubler
doublet
restaurants
beautified
abetting
manly
legatine
reserv
expert
equivocate
toledo
fleshment
bourn
beetling
forwardness
premise
symbolical
servingman
rasher
restaurant
quarrelsome
foreign
quadruped
ramsey
sulph
possesseth
baltimore
poins
despiteful
nextel
point
ravages
pygmalion
tennessee
_untutored_
asserted
gnats
ravaged
expensive
partialize
weaving
fructify
fenny
apostle
smoth
appall
rivall
screened
rivals
faithfully
appals
misleader
assorted
honorary
roved
enchantingly
dissension
resisted
politician
grains
abatements
elections
horseshoe
deferred
wiselier
unearned
portugal
century
perilously
upbraidings
confining
stover
counterfeited
bristly
curyarnon
shipwrecking
bristle
subcutaneous
riddling
windmill
strips
lowing
resounds
ardour
fustian
signor
minstrelsy
travers
task
whores
scriptures
panelling
withdraw
tugg
scaffoldage
stelled
examining
irritably
obscur
heartlings
shape
shrewdly
irritable
alternative
madding
timber
depriv
cut
cur
cup
marrying
source
cue
undistinguished
murtherers
cum
easter
suffocation
womanly
jointure
stanchions
intel
knock
addressed
snog
purveyor
borrows
foolish
valleys
collectors
diocese
absolutely
chertsey
wreckers
delegation
triumphing
presences
candle
playeth
balms
decision
proficient
scalps
balmy
gallops
epic
inimical
_congealed_
oes
oem
accoutrement
feigning
standest
triton
goosey
depose
tiff
relapsed
retailer
seating
obscenely
relapses
ruminaies
liege
hopest
loveth
immortality
translate
puttock
murphy
ridest
_remotest_
subsidiary
forbiddenly
planed
concernancy
planet
_make_
planes
grumblest
tanzania
repulse
constant
curs
puget
stripped
thereabout
deprive
rarities
curd
cure
curb
appetizing
_helm_
curl
cafe
tybalts
stripper
pecks
knaveries
_negro_
yang
ellen
confine
wonderin
_adriatic
cellar
monmouth
_americans_
intensified
restoration
cater
cates
utterly
phenomenally
worsted
implies
overlooking
wards
bankers
_saxons_
implied
presenting
ephesian
valves
whiting
fitch
tombs
wrangle
kindless
groceries
hereto
tombe
strew
compose
shyer
vietnamese
franciscan
statures
literary
compost
tradesmen
pleasing
nervousness
presently
disclos
chewet
implicitly
startlingly
hoards
chan
untouch
embay
carman
entire
busied
announcing
transmutation
one_
bizarre
havens
toucheth
rector
thronging
rivers
natron
mayhap
manlike
carlo
edison
dowdy
conspir
bail
assisted
furth
access
infinitesimal
currently
pleading
waterfly
apologetic
beasts
sunsets
spatulate
packing
healing
safer
condolement
cretan
talent
redbreast
principally
climb
honor
corresponsive
composed
faultiness
unfeed
accusativo
vulcanite
methought
composer
composes
flatterers
che
chi
unwhipp
providers
readable
hammered
punishments
butler
hammerer
defendant
charcoal
prized
ethiope
snatching
respondents
guynes
flaw
definement
napes
prizes
minions
fooling
whiffler
reynaldo
luces
closing
fetch
pyramides
analysts
invoices
teamster
disports
worldlings
gangren
syrups
invoiced
andersen
baisant
noises
havior
formations
varies
wittiest
profile
tiltyard
relates
watch
highs
carbuncle
hight
prostate
pleasantness
affinity_
lecher
chasing
foxship
congruent
trembling
chambermaids
furious
subsequently
unmade
dispraise
adjust
foreknowing
despite
disarm
contriving
symbols
circumscribed
horns
flattering
squier
horny
galaxy
recordation
dungy
raby
considerate
_sinew_
accredited
yeoman
eur
sapling
pangs
beads
bolden
applicants
flail
frayed
hisself
cimber
cider
uncurrent
inculcate
phonetic
incenses
resistless
averred
elflocks
baulk
jephthah
cobwebs
pantry
ongles
incensed
mistrusting
sexual
_viscid_
porpentine
sentience
melun
barley
flushing
dawned
approached
residuary
fourteen
approaches
que
curvithick
tremain
qui
viewlessly
quo
backwards
allies
yare
rearward
mortar
recipes
yarn
allied
mortal
kildare
elegiac
braced
reaches
betrays
whoop
lagging
reached
moiety
suffic
scann
excrescences
bologna
habit
erraught
fahrenheit
intermediate
acquiescence
scant
explanation
nobody
foamy
inestimable
foams
ratcliff
coughed
mucilages
treatise
animiles
impaint
sweden
tenements
assays
impale
abstracts
_investigate_
starveth
wotting
accited
passioning
cavern
have
throat
dercetas
accites
gingerly
incentive
montgomery
schoolmaster
concerns
ramping
spinster
alton
combless
personated
enamell
procure
deathless
prisoner
payment
personates
inexorable
beets
disease
cytherea
occasion
contemptuous
pelion
thicken
ejaculated
_for
doughy
hamlet
tearful
traitor
_cotton
571
thicket
thicker
handmaid
setter
isself
_poet_
lolling
knowledge
tithing
lyen
scorpion
contumely
prolong
prancing
emitting
communist
shouldering
pitfall
regularly
supposal
starch
swoln
facilitated
perfection
panelled
spriting
gorgon
monopoly
fixes
teams
mercedes
fixed
turkeys
reiterate
tiptoed
intensity
daffodils
racket
imposition
reform
brunt
difficulties
encamped
boundary
tediously
ilbow
monarchs
weal
reproduced
sorrow
monarchy
antics
placidly
antick
armenia
mows
monarcho
disport
commenting
alaric
southeast
joke
occasioning
equal
pulp
tripp
wringing
masses
cornets
brool
statues
mls
denis
manhood
attainture
johnny
transylvania
swimmer
arbitrary
magnetized
seasoned
drowsy
rump
ercrows
citadel
transfusion
meus
assessments
hautboy
welcoming
widescreen
spasmodically
venomous
fumbling
pantin
alengon
japhet
delusion
weighed
arrangements
suspiration
creak
partner
pedestal
tumbled
whirl
grinder
tumbler
powell
mildly
garish
prais
cosiguina
discredited
breech
sisters
prain
superabundant
recourse
neural
nevertheless
builder
chastisement
exceedingly
anglish
boskos
posset
comparisons
raving
builded
medley
stores
numbering
storey
interim
vocational
griffith
wether
civet
censorious
gmc
onward
demographic
aruba
281
embossed
paphlagonia
reformed
gmt
resolved
elapsed
mods
peating
resolves
longaville
displaced
berghem
capacities
like
success
admitted
scullion
chick
arising
livelier
kaleidoscope
floodgates
straightway
classical
scurried
hain
hail
hair
recommendation
happens
hurricano
iachimo
apollinem
discretion
screwed
brims
complices
lieutenant
marketable
terra
quills
justin
godalming
introduces
furies
bumbast
conjuration
tomb
upward
seniors
faithfulness
planners
socks
female
earthenware
unfashionable
knuckles
1634
undemonstrative
elastic
pictur
junkets
condense
rushes
inasmuch
development
glimmer
seniory
sequel
insured
misdeed
seiz
flip
1180
tricks
domine
replying
whisper
measure
domini
transfused
periods
commentators
_interment_
xxv
minikin
dressed
_allusion_
detail
detain
prated
impositions
strewing
manoeuvred
_crude_
dresses
dresser
chroniclers
behavioral
augmentation
geck
cheque
bonneted
stirred
grimmer
stirrer
fishified
pashed
vermin
delicates
sci
appetite
drumble
glides
345
347
whatsoever
grossness
metamorphis
caddis
haughtiness
dispense
vitreous
gratification
vastly
tremblest
school
affordeth
glues
informative
glued
stereotyping
veritable
disciplines
guidelines
feathers
direct
_stratified_
nail
disciplined
_manual_
blue
hide
selected
revolves
revolver
supplied
fatness
liberte
xvii
causes
blur
ebbs
supplies
jaundice
primroses
philippe
prate
philippi
beck
abbess
paramours
tx
ravish
leaves
leaver
museums
forwearied
hardocks
settled
midway
exeter
prints
imposthume
godmother
morpheus
patience
meats
velure
pantyhose
would
prescript
tenders
distributing
knitteth
erstare
fainting
coffins
incumbent
peaseblossom
befriended
portraiture
unfather
elsinore
excellent
vpn
supplemental
abundance
tb
fakir
_gum_
geometry
deficiencies
experts
salvage
defile
estate
ardly
childless
preserving
mermaids
overheard
veresti
assistances
appointment
deesse
attract
harmonium
calve
overpowered
obloquy
bathometer
cadic
enquiry
drummer
enquire
toxic
dialect
elizabeth
bretagne
famish
imaginable
lump
montague
befor
unguarded
tidying
airless
circumscrib
parallel
splendid
casement
amid
bacca
waftage
prosperously
upside
overtopp
plagu
preventive
alack
passon
amis
deform
crimeful
crumbs
staining
beside
fealty
img
wilton
tilth
tilts
baily
400
wealtlly
murkiest
408
frampold
blots
iowa
diseases
touraine
prevented
almsgiving
30th
ripens
diseased
17th
rental
gluttony
alex
swaying
quadrangle
detroit
ales
consulship
lusty
railer
milwaukee
fishpond
satellite
juggling
pewterer
appurtenance
saturday
revisions
silvered
lair
psychic
sighing
christianlike
laid
banning
lain
wooingly
aweless
independence
prorogue
provide
clearin
associate
disputations
aforesaid
anselmo
sods
parricide
unwiped
days
tolerant
filter
probal
soda
separable
maggie
officious
mountebank
researches
primary
fantasy
adopted
nhs
insulation
quoniam
bolters
attraction_
merrier
appeles
attack
fiction
confirming
dee
gowns
corpus
illiterate
191
190
kindest
incur
lozel
tantaene
lather
begone
reclining
frankly
immigrants
expostulate
bridge
handkerchief
thistles
screws
gabble
seminar
perigort
unresolv
thoroughly
thorough
brandon
derek
aurelian
hatch
_temperature_
phenicia
promotions
potency
accreditation
faulconbridge
cambio
screensaver
entertaining
swifter
dighton
seasonal
pardoned
bait
dupp
silverly
endear
alight
basimecu
colors
pardoner
nubibus
surety
bain
afeared
hawser
spite
situations
undiscover
minnesota
spits
censer
knuckle
stephano
borrowed
fontaine
scientists
borrower
wedding
knocks
toolbox
undressed
semblative
angers
anxiously
egoism
egoist
penance
motherboard
yawned
sharpens
paros
crieth
hagar
disturbing
molehill
waywarder
mus
feline
continually
grandmother
mud
mug
discovers
hopefully
mum
1592
mun
discovery
drowse
clippeth
rims
deposed
esculent
however
disdaineth
news
cashiers
_repulsion_
newt
greenwich
hermetically
fault
dearer
terrene
distinguished
bet
expense
behindhand
standings
starling
palamedes
conference
seein
demesnes
warehouses
unmatchable
tabs
schoolroom
captives
unchanged
_brahmins_
anchors
winningly
vulcan
xxi
cursies
apprehension
n
natives
quincey
quinces
broth
tions
accessories
dazzled
scythia
fanes
demoralise
pathology
_kept
effus
unsavoury
casques
prussia
averring
forehead
drawback
usurping
peaks
schiller
screw
numerical
greeted
shortly
darnel
possessed
ocean
impediment
admiringly
jean
possesses
leaguer
leagues
rubies
departed
proposed
unemployment
goffer
bruise
proposer
proposes
grades
leagued
depart
scattering
enlighten
expos
cherry
_combustible_
causest
farmsteads
gave
unconfinable
breaks
sufficiency
descending
59
burns
burnt
rumor
melting
mansions
zeal
contradict
orlando
renamed
medals
hunt
51
spongy
zoom
chests
chaud
usher
election
_pension_
contests
rapidity
teneriffe
_dutch_
preventions
mystified
loins
skylight
extirped
incontinency
flaps
deleted
brawl
hampstead
brawn
bleated
tinctures
parenting
attacks
choke
unreveng
choky
dinner
outfacing
ensure
ppc
duke
abet
aha
dials
ferd
lavishly
obscene
bath
abed
batt
bats
fery
herods
abel
regardfully
sunlight
timelier
stuck
striding
inquietude
wittenberg
amateur
excerpt
gorgeous
pricked
_codes_
alehouses
forborne
pajock
sponge
flavour
consequences
loitering
unfathered
zodiac
worshipful
cobbled
stomaching
suspicions
sometime
cobbler
levity
silliest
_compartment_
charioteer
counterpane
swineherds
substances
when
blesseth
vesper
petrofsky
setting
whew
whet
papers
whey
proconsul
kerosene
picture
grasps
suppers
football
_mathematician_
beastliest
nordau
1807
1806
1805
vetches
faster
moustaches
sacks
vigorously
jealousies
1809
uncovered
fasted
remarked
fasten
6221541
undoubted
roi
rom
yokes
grovelling
rob
rod
roe
yoked
tripartite
parker
marion
deprav
ros
rot
row
belkin
passage
matchbox
determinations
ebrew
exalted
frequencies
trident
sponsors
unfamiliar
anyway
wallets
congregation
tanks
emphasized
oftentimes
gaudeo
churchyards
clouds
leven
level
posts
cloudy
mournings
differential
slouching
lever
poste
tenths
pork
illustrating
pugging
porn
trend
tarries
injunction
pore
centrifugal
widened
colin
trent
rowtor
angelical
tarried
colic
phorbus
stately
corbo
goes
goer
requites
slaying
requited
entertain
witch
ershot
boast
hearkens
cockerils
preachin
exams
seams
puerto
whitsters
bribery
durham
jewess
erturn
crisis
conjoins
bulbs
athens
variously
voudrais
lintel
prey
pret
prev
prep
today
roared
diurnal
suggestions
casey
attained
_science_
cases
confucius
lumbersome
sailmaker
inveterate
_ask
vailing
pickle
meeter
supportor
nursing
figure
irruption
righteousness
critic
unseminar
unloads
_extra
churls
bigot
sidney
floulish
vital
fourth
vitae
husbandry
fishmonger
eighty
informs
trickling
representations
pilate
wagging
glowering
practic
succeeded
direness
_memorandum
superscription
inform
unskilful
practis
_line_
representation
lamented
hugo
wainropes
bate
unspeaking
fere
dreading
preeches
platform
_membranes_
farmer
priesthood
deceivable
qualifies
weathers
footman
blawin
qualified
naturalized
porters
permissions
inheriting
debating
lamound
tribune
subjection
_sculptural_
ejaculation
torch
shrillness
catching
farewell
beehives
tumultuous
exertions
anoint
counterchange
putrid
concur
celsa
intercourse
envenom
condole
abounding
grecian
she
eagle
costumes
existed
castile
tamarinds
bloodshedding
browed
solicitous
envies
unsound
yus
turn
turk
raleigh
envied
turf
turd
excommunicate
supernal
transform
cheerfully
gif
burying
virgil
champain
grund
_preservative_
enigma
salvator
naught
grunt
milton
posin
bewitch
oozy
pigmy
crusadoes
accused
ooze
cards
pricket
correctioner
suspense
wanderer
blackheath
wandered
sciences
animation
resembling
forbod
surf
surd
sure
spangled
adversities
nvidia
remunerate
donation
stats
icon
wireless
payable
shooter
incardinate
cuckold
pipers
lated
satisfactorily
smulkin
everlastingly
urge
forage
cheat
allegations
trod
dirge
troy
spaces
trop
trow
trot
snarleth
supporters
gull
arraigned
surmises
believing
deign
fatherly
lug
mortally
portions
moveth
contrivances
jokes
scots
predicted
_5
phraseless
signs
thoas
surfaces
cialis
voluntary
runtime
crooked
acheron
commitments
odessus
erwhelmed
decorate
rumours
_product_
guitar
hempen
butcheed
harshly
acquiring
libya
quier
quiet
contract
unheedy
railway
ntsc
unvirtuous
filtering
arkwright
inspir
period
insist
pencilling
babbling
nicole
_gravitation_
turkey
subscribed
sympathiz
consultancy
subscriber
subscribes
featuring
henton
peaking
direction
exasperate
budgets
andres
andrew
confutation
thwartings
andren
coherently
plashy
spirit
protocols
pilot
case
casa
couronne
cash
cask
fiercer
cast
insisture
mansionry
cordage
_inscription_
impaled
revolutions
participant
author
granted
eggshell
unaching
nighted
frequented
week
ween
tipsy
urchins
weed
director
fowls
delicate
statue
weep
weet
reliev
bodied
delectable
without
relief
inability
bodies
sinner
soundingly
ninth
spliced
cease
polish
favouring
tellus
ditties
lets
discerns
lett
bleats
flashing
encave
disproportioned
inordinate
birthdom
dismemb
keckle
acute
shipwrights
towel
patrick
donations
tower
snatcher
snatches
wooers
jewellery
shillings
competition
canova
snatched
redeeming
developmental
mood
frees
freer
luxembourg
mercenaries
moor
bents
porter
freed
whettin
beached
unmask
slaughter
miscellaneous
unmast
parishioners
prattle
beaches
energetically
dozy
discussed
whence
doze
discusses
tribe
rued
nods
denay
curses
instruments
warbling
cursed
brunette
rising
burton
flushed
msgstr
whales
there
relocation
alleged
cultures
mischief
spose
relit
rouse
wholesale
appellants
gutindex
grasp
flats
grass
creeping
flatt
username
accentuated
freestone
sciaticas
felix
hoyday
minneapolis
nefas
scotches
roomed
rosed
deserve
roses
vietnam
digged
staffords
deviation
pillows
inquired
uncorked
contradicted
cordless
dishonour
bullets
inroads
finals
semicircle
candlelight
wife
wifi
platted
websites
reproduce
directors
treason
directory
bequeathing
crumpled
wreath
barons
tarre
meditation
decisions
barony
glimpse
apartment
ron
subsided
revengeful
execrations
dairy
nowt
crest
celebs
hests
tethered
llp
egyptian
infringement
votarist
prognostication
gainsay
treating
roy
lisp
clinched
_oleum_
list
crystallization_
liars
renouncing
lisa
unqueen
familiarly
flick
employing
invention
courtezans
whene
corantos
sug
harden
sue
demure
cuckolds
sum
rascal
brief
version
pulpit
sur
sup
brier
sonneting
coact
cality
womb
compresses
toes
ruffle
rehears
unanel
drudgery
compressed
equations
tragedy
naval
nosegays
horrified
stiffness
tramping
camcorder
conditioning
tragedians
atomies
liggens
enlivened
intrinse
herring
clifford
quasi
rustic
garnish
angrier
horses
flat
israel
flap
archbishopric
mirk
presumes
mire
_brought
sorcery
flax
flag
auvergne
miry
horsed
flam
ensu
outliv
salted
searchlight
azur
conspire
ominously
salter
andronici
terrestrial
ordinance
untied
occasionally
headstrong
handsomer
sensations
okay
sabina
_decomposing_
shrivelling
_electricity_
adventure
concentrating
proclaimed
rambures
short
susan
jove
shore
shorn
antidotes
balloon
isinglass
benedictus
emmanuel
broths
pretext
avenue
thirtieth
processed
mattress
bout
soccer
somebody
kingly
cements
hunter
hunted
adventurous
instructions
intolerably
mathematician
fearfull
liniment
tactless
mastered
mastercard
accommodated
likelihoods
intolerable
pleasanter
weighs
tilted
weight
oppressed
tilter
enon
loops
oppresses
croaking
hily
alcohol
disquiet
hilt
hydraulic
faqs
lucifer
hill
countermines
laming
friday
wishin
upc
threepile
peaceable
_device_
jew
preliminary
fantastical
minuteness
misreport
tate
reefwards
prejudice
wildflower
fallen
harpers
shrewish
seeming
playfellows
vellum
shemales
urinal
enlarged
vouched
intestine
traveler
gpl
avez
story
conventicles
swales
leading
interviews
tougher
britaines
storm
ventricle
store
temptations
shearers
calculations
pgdp
luckily
deedless
rifle
wayfarer
shrunken
king
kind
kine
skamble
kink
scabbard
kins
scanners
voucher
unrelenting
motivation
hevening
exert
daintier
dainties
shrewd
flagboat
overran
tongued
shrews
wilson
rochester
gallian
port
foamed
irritated
electric
exec
gild
inconvenience
architects
fangled
trudgian
gilt
defensible
amaz
farmhouses
dealers
lumbert
traditional
forerunner
_somewhere_
lying
unspiritual
vaunted
barter
vaunter
howls
dutchmen
plantage
tilly
grazed
sheppard
justle
founding
gains
invoke
cote
knighted
reprint
emails
grievances
expositor
wroth
cringe
wrote
forego
dishclout
barefac
craikin
defense
chambers
heaped
purified
threats
surmounted
blurr
blurs
frugality
solo
induc
attention
aspir
confiscated
sola
jetties
imp
baleful
franchised
bandit
vallant
overset
sheathe
reside
nettled
distress
sweet
sweep
harbour
deposits
regulated
nettles
village
mistak
startling
pining
somever
nato
_lively_
affectionate
_commentators_
flight
flints
latterly
flinty
precision
softest
chastely
marcade
demand
overrunning
masel
scelera
equivocation
unconquered
shove
workmen
frozen
quiddities
versailles
shortened
credence
styx
fetlocks
demon
styl
obstacle
laundered
chestnuts
choler
farmstead
shirt
norton
shire
9
daughters
higher
restraint
cement
liquids
contractors
fariner
broils
magnified
tarnish
pindarus
stuprum
dulling
267
lording
marchpane
burden
pates
emerge
pated
repealing
monging
questions
insuppressive
continent
meanest
immanity
speedily
difficile
countermands
tormented
shovels
finder
clemence
advocate
clemency
jacksonville
almanacs
confront
hecuba
almanack
uproar
exploiting
divining
sauced
disinclined
dickon
silius
candy
renegado
sauces
saucer
controllers
rien
inoculate
retro
scandy
ostentare
ries
contrasting
descried
perpendicular
refused
dustiness
consolation
vaccine
russell
comfits
pipeline
asserting
inheritrix
bristling
niceness
plaza
lifeless
range
complimentary
fluttering
youthful
fleets
scorns
paralysis
auntie
johns
inventoried
heedless
dexteriously
flickered
bodements
artifice
enfreedoming
_constellation_
impressed
rows
acquiesce
lone
long
gainsaid
childishness
summertime
andy
forgits
squirt
audacious
gracefulness
raftered
thrilling
forefather
fulfilling
hideousness
arter
sullied
redress
ands
warmer
sullies
aboord
landscapes
voivode
shes
back_
tiniest
steeped
trumbull
prescience
reservoirs
congealing
huntin
whirligig
rainbow
camcorders
peach
peace
backs
saffron
nick
laquais
muffle
extinction
nice
dale
_fusible_
postern
users
breasts
medina
chequers
meaning
allowing
posters
hemm
wrinkle
happier
happies
wildness
departments
microsoft
impatient
_marbre_
almain
distain
harcourt
outbuildings
buffalo
moorship
reined
_varnishes_
stumblest
alien
windy
milfhunter
gang
winds
discordant
uphold
fortresses
tadpole
languages
_saline_
bedrench
breach
include
dandy
confirmation
mainstream
enchaf
disquieting
_registering_
foretell
sheds
enchas
staled
disgrac
extenuate
matrons
melodies
friendliness
unminded
disclaimer
concluded
toils
plows
wrestling
appertains
euphrates
frighting
enamoured
concludes
acid
makers
folk
unavailable
compar
showcase
sueth
overwhelmed
19th
unruly
uncurbable
bondmaid
degree
federary
stowe
youngest
explore
blameful
settling
survivor
distressed
anthropophagi
larger
shades
uncuckolded
leaving
suggests
imperfectly
submerged
requite
youtli
distresses
writer
egypt
lafeu
apt
hardy
sandbag
duck
doubtfully
ape
from
shakily
frog
procrastinate
examination
mistaketh
eagles
thersites
solum
verite
nemean
parrots
importeth
verity
lichas
joinings
executor
dissolve
thirsty
discandy
thirsts
assumptions
hilton
serviteur
counting
syndrome
hinders
ergrow
struggles
roughness
menecrates
camillo
toddler
typewriter
attend
heavings
misgave
detests
militarist
tack
wrist
unnaturally
1887
1881
lapwing
budge
villas
freebsd
unbelieved
_whitby_
appelons
violator
perishing
reeling
minnow
interpreted
strove
beautied
interpreter
unchecked
glen
superior
pippins
glee
holidam
helsing
receptacles
holiday
crowds
unsaluted
adornment
devel
ambition
terence
diabolic
successor
articles
lockjaw
footstool
edit
trimmed
brusquely
_descendants_
cocoon
popocatapetl
oui
freckl
weening
mundane
our
out
southerly
empiricutic
ingross
honorably
sentiment
cerebral
gossamer
chaos
turnscrew
overtopping
plaguing
honorable
frankness
disclose
_zeal_
planner
pours
utensil
tenement
tenant
organic
waterloo
g
islamic
loggerheads
enfranchisement
regaining
hence
biting
crm
universale_
embryo
undid
itching
realtors
bonnet
eleventh
twas
filial
tway
_access_
unknown
accountant
eighth
priority
1500
1508
bulks
unceasing
swounded
diminish
astounded
reaped
holland
lucius
humours
volsces
indistinct
encore
faints
tracts
clip
fowl
unpitifully
linked
disjoins
pallor
reeky
pupils
bouge
aberdeen
bough
reeks
boastful
_husbandman_
commissioners
chaffin
martha
brigandine
sempronius
whe
hq
twittering
collaboration
who
damply
moveable
why
tinct
polyester
pips
purpled
ensues
pipe
_incombustible_
returnest
determin
drugg
swarming
purples
suffigance
sutler
agreed
pleaser
artfully
chapters
bountifully
senegal
betake
utter
fear
feat
agrees
litigation
nearer
succour
manacle
furnished
christenings
undestroyed
studded
local
fraudful
sanctities
topple
monuments
massacre
peacemakers
cubs
burglary
polyandrist
anatomize
ellum
titus
married
sauntered
leviathan
juror
ascertain
marries
cruet
available
requirement
heathens
tregols
buzzed
collectables
suffusion
despoiled
guildhall
crudy
drawling
monstrous
carriage
favor
identification
wetting
boughs
besmeared
razure
daintiest
defacing
jot
conclave
dateless
joy
job
joe
certainer
jog
fastolfe
jon
marrows
enskied
waisted
valiantly
april
retrograde
grounds
panthino
tunisia
mania
growin
guiltiness
heredity
rpg
dividend
investigator
rpm
unclean
stupor
decent
grindstone
trademark
boatman
arbitrator
reservations
naples
remedies
bedded
scrutiny
ensuring
conferr
remedied
admonishments
esperance
fearful
permafoy
lineaments
stunning
ensconce
medicinal
observ
chapless
ringing
thus
draining
combustions
_destination_
lightweight
shuffl
thud
clovest
perhaps
maddening
largess
geographical
largest
embattailed
difficult
clamors
swoll
maculate
unreconciliable
promo
conceived
disagree
romeo
throngs
conceives
warming
valeria
correspondent
undertakes
undertaker
banging
_terminated_
cheveril
slenderly
undertaken
volivorco
amazedness
excessive
camel
tcp
treeless
pricksong
guts
arresting
clothier
tawny
usage
jars
smart
stakeholders
rememb
provisions
betroths
execute
_friable_
facial
press
pleaders
prest
flemings
safest
shipmen
perpetual
roundly
feigned
hosts
pasties
wonders
exceed
smoothly
bowcase
unnoble
employment
vitty
jeremy
frosts
pasty
flaunts
tenure
swaggerer
fordo
sevennight
uncomeliness
pasta
paste
unwatch
rare
carried
brabbler
wadebridge
_hindoos_
abstinence
malvolio
sakes
carrier
ashy
phantasime
_30
irishman
outstripped
converging
individually
gladsome
polished
strangeness
clifton
soaks
weather
promise
lawful
fawning
fisnomy
crystallization
spiral
trenches
trencher
fertilizes
cszeks
resists
trenched
titleless
nourish
hollanders
bigamy
volume
cotton_
lither
automated
assail
florists
protesting
nightgown
unhop
languishings
cake
faggot
1740
monastic
willers
bewail
kamtschatka
ploughing
sheered
kneaded
visa
tullus
quails
incredible
simular
glint
curtained
1292
repute
gipsies
1294
conclusion
kinds
nourishment
pumps
kinda
squeak
toasts
squeal
readiest
auxiliary
peize
_institutions_
sash
writings
glamis
yellow
sunburning
prefix
conjuro
conjuring
marching
electricity
consulate
flicking
_vocal_
protestants
kentishman
figo
regional
dell
farborough
forties
figs
rancour
prize
buttonhole
satchel
plainings
ercharg
specialties
succession
reliable
charter
glassy
infringed
miller
blacknesses
millet
sanderson
crisply
tether
sterile
milled
characterless
ruthless
pharmacy
increasing
etexts
insinuation
alarbus
avert
error
fronts
undivulged
substance
military
majestee
dispiteous
strews
divide
explained
civilities
scoffer
remnant
dearie
txt
cheating
spoke
tardiness
accurs
overshadow
glimmering
telegraph
glideth
nessus
relay
caracks
successful
motors
huntress
whirling
hurt
tying
hurl
chequered
pontifical
harkers
fifths
famed
blade
ironbound
enfreed
misfortunes
vanities
melons
breese
household
bitterest
organized
dragons
oclc
respose
organizer
reprove
1757
thimbles
complaining
damage
machine
methodology
epinions
preferable
gaming
clothiers
cowarded
shores
quips
destined
mortars
obscuring
calves
effective
scourge
wins
attracts
wink
calved
snowballs
specks
crocks
keeps
wing
wind
wine
__
restriction
_rabbins_
nourished
vary
profaned
vara
soothingly
lovingly
rankings
_t
matured
mewling
hidden
_a
glorify
enrich
drabs
unfledg
township
parasols
silver
structural
rumour
represents
ranked
_8
_7
_6
_extinct_
_4
_3
_2
_1
dumps
dumpy
disvouch
expectancy
preceded
financial
dutchman
woes
garment
bowls
_commerce_
fortnight
laboratory
expectance
blinded
diction
dst
sms
urbane
semiconductor
dsl
exaction
gertrude
assured
clanking
theirselves
cholesterol
fugitive
_her_
inscribe
assures
ian
sensors
alert
knit
metallica
bates
scruff
bated
parricides
coquettishly
potions
necessity
shopper
wasp
subtlety
wast
wash
instruct
lucianus
179
178
177
176
niger
174
filching
172
171
170
carnivora
agueface
engagement
lege
legg
listed
blossoms
legs
blossomy
listen
danish
collapse
geneva
fibrous
frowned
wisdom
modena
sulphur
17s
freemen
coursers
surer
halfcan
signin
outlaw
grievingly
seminars
pioneer
endure
entail
stertorous
humouredly
concrete
responsible
eagerly
metallic
causing
delille
disdainfully
hurtful
cymbeline
stirrup
miscalculated
doin
tinkers
rford
looming
victoria
doit
affirmation
letter
ipse
retaining
drought
dealtime
listprice
morality
episode
grove
professor
gordons
braying
clasped
nerissa
fraughting
mortise
advisory
bomb
departing
advisors
brogues
nominated
soluble
gauge
malleable
shirley
hungary
caper
procreants
capet
shuffling
sies
cousins
buxom
cupid
mens
_combustion_
theme
specify
butterwoman
mend
telegrams
capel
undeservers
nev
_oil
lenders
fetish
hinderances
gallia
charcot
halfpennyworth
lurched
flanked
surfeits
fait
traverse
leasing
disaster
fair
fais
guerra
consummation
sapless
bled
reprieved
fail
bess
fain
nocturnal
best
stealthy
abeyance
score
scorn
pirate
preserve
claws
usance
_en
felony
twinkling
_ex
carbon
angling
goblet
adapter
readers
adventures
capulets
estates
normandy
quests
betrayed
admission
_irruption_
vail
vain
wynds
happenin
canyon
16728
beachy
vais
darlin
251
256
254
startles
chrome
dignities
breathlessly
extraction
savin
startled
dreg
tutorials
exactness
life
reguerdon
milfs
awse
athol
lift
pairfectly
chile
child
chili
erst
chill
oogly
pastime
skirts
_invaluable_
truster
hatfield
sophistic
obeying
australia
madonna
bounteous
trusted
trustee
gentilhomme
fotos
intituled
veals
demeter
ilion
cumulative
removals
feebled
swarthy
babies
swarths
contenteth
fairly
jamb
tops
topp
pioneers
registering
meads
intrusion
bonny
unhook
coldness
fittest
blackjack
opinions
cincture
masons
forsaken
disguise
groweth
tilde
plight
godfathers
alum
predeceased
canidius
ewes
ewer
collections
delinquents
casually
preserv
unproper
possible
twinks
firmer
possibly
barnacles
birth
unique
massively
spurted
articulated
blunt
seaside
bermuda
pavement
steps
ab
prologue
bocchus
people
predominance
ungenitur
commonplace
warring
peereth
unvalued
_league_
gasps
sociology
for
hulks
soto
camphor
fox
marseilles
foe
fog
sots
fob
serpents
foo
foh
foi
pinched
energy
dental
shifting
unmuffling
pincher
pinches
_manufactory_
cemetery
transcends
rebuk
dollars
citizens
_flambeaux_
despair
repellent
emilia
rebus
attica
gauze
nought
brutes
presenters
mambo
reducing
grano_
avail
width
call
happy
therefrom
manufacturers
fascination
tigers
paypal
conclusively
gripes
shrilly
necessaries
andes
shrills
_24
circumstantial
silliness
mirthless
pest
lays
mighty
_chemical
_21
cliffords
juvenile
geminy
proved
tournament
proven
crumble
soothe
proves
exist
accounting
cassia
dealer
posting
crutches
protested
solicitation
beaded
perpend
actor
republic
unbruis
conferring
developers
worldsex
demonstrative
maimed
deathbed
invested
persecution
wrackful
spades
diadem
sniffed
ottawa
varld
goaded
prolixity
woodcocks
peacock
pumpion
gripped
resources
crocodile
moldavia
dowries
towardly
manured
venice
unremovable
ver
yerk
rousing
vex
_sculptor_
hobbies
manures
quickening
unremovably
prepaid
cheap
refinance
votary
mourn
farre
wondrously
unhallowed
tear
teat
solved
team
melancholies
bonfire
mahu
prevent
minion
gasoline
befortune
attir
venge
cleanliness
suggestive
current
guienne
deadening
distempered
amalgam
enfeebled
muskets
persecuted
molestation
crumbles
gulf
studied
wherever
commonly
crumbled
charybdis
studies
reclaim
concealed
love
bloods
bloody
purus
ips
divulged
relating
_conspired_
cherisher
cherishes
positive
freshes
predictions
tightly
imaginations
cherished
wondering
calgary
enfeebles
introducing
afford
apparent
odious
reprehending
easiest
epitaph
involve
valued
believes
nether
interracial
values
slowness
believed
webster
palings
hides
melbourne
winter
grosset
grosser
pendulous
elephant
parameter
vagrom
cavil
undercrest
jazz
blasting
spot
uncompassionate
applications
misshapen
filths
date
data
conveyers
disagreeable
sectors
fatiguing
yielding
garlands
definitions
usances
devonshire
boreas
epilepsy
thomson
hiring
bucking
solitary
solace
keepest
attraction
covertly
creations
homestead
decades
into
petition
equipage
matches
messrs
feelin
records
mightful
arriving
epithets
_practical_
runners
matched
startingly
beldame
revers
_festina
beldams
bowling
argier
manors
dramas
compil
whosoever
agamemmon
giddy
canvas
container
brags
rounding
worldcat
bragg
_elegiac_
cornfields
suggesting
reveler
flurries
sheffield
million
envelop
possibility
intensely
disguised
discussing
chattles
spam
misuses
ostrich
disguiser
disguises
impure
doolittle
recompense
misused
gratillity
intuition
fleeter
properer
potter
nested
fleeted
settin
biol
habitation
vote
chubby
tenpence
scudded
indicate
2
complexioned
typing
downloadable
ahungry
unbatter
renfield
blazon
floppy
tuneful
execrable
meddling
padding
spas
representing
storehouses
reprieves
exacted
future
spat
festinate
scuba
prospect
tasted
nicer
tastes
suffrages
lurking
deflowered
sanctimonious
glimmers
knead
superfluously
unlearn
jefferson
take
poster
lodgers
altered
blowers
unkindness
pantingly
abut
abus
ruffs
pulpiter
farmers
constable
occidental
managing
bade
_hieroglyphics_
refining
axe
silkman
affirmed
schoolmistress
walking
surplus
unassailable
mince
_ignoratio
fife
xml
fibre
merlin
unkind
unking
_selected_
robs
imbar
hockey
equipped
castiliano
robe
caroline
clawing
robb
roba
indentures
resenting
infallibly
individable
nooks
cursing
infallible
flatterest
intermixed
perus
unjustice
advisings
though
liable
fortify
disparage
caphis
vanquisheth
gout
sleepers
sheathed
surgere
raged
cio
up
espy
sheathes
misprised
surgery
ur
dives
diver
rages
mecca
unurg
fixeth
intil
navigated
goers
therewithal
upholstered
affecting
teens
presage
untainted
uncurbed
guatemala
tiberio
unhospitable
faded
jovial
reigns
whoa
jets
undermine
loudly
expression
regardance
twit
unmov
ants
twin
prun
anti
sentinel
twig
mousetrap
1588
1589
wearers
unconsciousness
1580
1586
vacation
brahe
breath
combined
crawford
xxvi
influence
thousand
antivirus
reposal
bonjour
berri
isabella
leiter
calicoes
pleasurable
girth
perpetuate
brow
ambient
toothache
apoplex
mercies
shuts
regentship
rooting
expediently
damon
workout
_combs_
breakdown
commixtion
swiss
cambrics
antenorides
cheers
harris
unmanageable
cheery
ycliped
puzzling
odium
escorts
undefined
academics
flocks
vacant
pacing
costs
engulfing
trains
blessedness
ransoms
whelks
exaggerating
bounteously
alloyed
snarled
uther
underline
weekly
raileth
hereabouts
pickbone
lengthens
chield
prominently
shrined
joyful
skies
colony
committally
fringed
clan
satisfaction
amputation
clad
62
clay
beverly
claw
sorcerer
slings
clap
laissez
putrefaction
lebanon
murtherous
racial
thinks
dimensions
tube
tobago
lysippus
landmen
oblige
marcheth
tortive
situate
robustious
tavy
destroys
keyholes
accessing
contingent
confided
unsworn
imminence
uttereth
ratios
contracts
lucia
acc
notebooks
scheduling
ace
_reverse
ack
industry
feil
acm
act
foulness
widowed
curling
exceptless
image
fritters
widower
parties
dout
enernies
wadsworth
bookcases
worshippers
recommends
longings
veares
shannon
buying
rotundity
phaeton
freathy
severally
agree
detailed
gone
charmeth
gong
ae
knavish
ag
af
ai
ah
ak
caustic
am
al
an
behest
as
ar
au
carved
aw
steeping
ay
az
maccabaeus
1214
oilcloth
laboursome
novice
embrasure
spatial
congress
annex
damnably
damnable
herbs
beulah
ostentation
sland
slang
comptible
neuter
emulations
impossibility
restricted
original
presentment
instincts
whorish
fairness
reasoning
throwest
particles
andrea
disciples
discipled
minver
dressing
premeditation
techrepublic
plaintful
tatter
orgillous
puzzled
unhatch
cucumis
puzzles
offal
candia
seigneurs
manageable
cunningly
condition
columbine
accompanying
marvellous
ingratitude
confederates
scrapping
dusky
poys
husbanded
penalties
sync
orinoco
canvass
turning
situated
polemberg
yawing
poisonous
burgundy
nursh
nurse
luxuries
contrast
installations
martext
indecision
hours
blockish
dreamlessly
yellowed
singuled
tyburn
sender
_dissimilar_
compliance
norweyan
pick
action
ertake
raze
marriages
excellently
indoors
unthrift
unbleached
archived
petroleum
bigness
implore
archives
pitching
ionians
homework
_used_
spoilt
spoils
shaggy
cunning
couples
keeping
science
chisel
topsail
westmoreland
evolved
17
cackled
beautiful
impacts
gallop
messages
rustled
neglected
accept
states
disliken
unbookish
sense
steward
tapestry
axis
information
dazzle
viperous
browne
browny
earnings
cling
browns
rously
candied
unattended
creature
anticipatest
countryside
tetchy
wiley
mapping
evaluations
acquisitions
debility
imagery
courteously
hauling
wrench
facere
emperial
fender
pans
mexican
radios
pant
fraser
haught
sinning
pang
pane
drossy
striplings
deeds
individuals
tyrian
travelling
propose
praetors
adoptious
consign
rosalind
pegasus
olivia
skipper
iridescent
recompens
misuse
odin
stewed
likeness
always
truths
tra
achiev
eva
errate
status
personating
bends
disclaiming
thisby
legerity
calicut
missed
sparingly
wilfulnes
silks
mattered
wakefulness
misses
nurseth
expiation
darling
downloads
highway
viol
drifting
porcelain
palter
paucity
_his
acorn
imagine
reproach
gallopin
leonardo
attainted
hulling
petticoat
rack
instigation
_idolatrous_
w
expedient
conductors
gazed
imponderable
slipped
guan
thereafter
chaces
number
ersways
slipper
gazer
gazes
indistinguish
executioners
_satirical_
heads
caracci
threatening
heady
vides
fruitfully
youngly
coppice
relationship
longly
immediate
consuls
trippers
delightedly
consult
focusing
fastnesses
progenitors
rampant
grace
diffusion
determines
imply
determined
marriage
empirical
unburnt
remembers
revelling
ranch
livers
fights
livery
vitally
dynamics
basics
engrossest
trowel
distemper
silvery
toryne
analogy
chawdron
commemorated
play
japheth
effecting
endymion
awork
yawn
plan
wive
plac
odorous
_decoction_
udge
unequal
covet
cover
coves
consistory
ext
mountebanks
exp
asus
smocks
abroach
strutted
rless
bringin
aghast
session
_quite_
impact
henceforth
indicator
condos
failed
symptom
grecia
apricocks
1460
gratis
impregnable
preparing
closely
_london
gratii
risking
sleeve
soonest
_exploit_
tottering
croatia
pecus
couriers
obscure
obscura
sew
sev
set
diomede
ser
seq
sep
overwhelm
sex
see
sec
migration
sea
seo
sen
sem
geologic
outward
vitamins
muted
sunders
roguery
taming
knav
knaw
avoidance
mutes
mammock
postponement
hooted
pagan
emnity
whole
volcanic
drunk
community
hollow
agents
brinish
holloa
poictiers
connexion
simpleness
worthless
filth
fathomless
acceptance
hitting
citations
scions
_castor_
firm
enwheel
sobriety
firk
fire
wheeler
mohammedanism
fund
towns
wheeled
firs
unqualitied
judicial
bemete
slobb
_granulous_
formats
anthropophaginian
owed
mote
moth
bizrate
owen
erhang
swagg
mots
owes
vanish
audi
funny
decor
moming
choking
maids
elevated
aleppo
pillagers
orifex
delhi
levell
levels
leaps
_sonorous_
silvius
focal
recent
oddest
herodotus
quags
loathsome
inflation
regulating
charbon
clearance
sims
torchlight
plagues
simp
canakin
mounch
telegram
_relics_
sima
plagued
mysql
theer
testimonied
hued
unfriended
chest
pillars
hues
snappy
testimonies
homeland
prelate
furniture
minerva
victims
demands
instructors
mischance
clutched
outstay
outcomes
lunacy
bruis
dormouse
fedary
pertinent
bruit
governess
exquisitely
reduces
_edifice_
canst
irresistibly
pashful
sighs
turmit
sight
flaying
indigent
momentary
rowlocks
wrongful
ursula
stables
incensing
stabled
tibullus
inclination
bd
be
bg
pedlars
ba
reddest
bc
bl
interpreters
lordings
bo
agreement
bk
bt
bw
bp
santa
bs
by
rapiers
wildlife
discontented
scepter
anything
hatchet
hatches
ambush
forgave
unsorted
hatched
thurio
computational
pincers
plainest
moonish
skeins
blench
primarily
goin
crossness
bargaining
chide
occupy
impudent
_state_
jewish
relaxed
tally
buttery
pastor
vowing
link
ling
line
coarser
immured
nieces
redeemed
horned
redeemer
immures
mature
horner
clerkly
supervisor
armstrong
defined
overland
limander
nebour
coasting
ensnareth
coctus
concealment
lostin
phantom
codes
tarquin
preventing
definitely
actors
brazier
sails
wrongly
hives
sided
faintly
robots
proclamations
missheathed
mealy
comfit
polonius
meals
hackney
trimly
invitations
trempling
rescued
indecorous
walked
sawyer
side_
summit
walker
rescues
essay
hampton
code
sorrier
ypres
renown
cods
september_
unthankfulness
goldenly
moon
lendings
zum
procur
diomed
grandly
description
send
ringtones
citing
outwards
dislike
sent
moot
entangle
garden
tulsa
drovier
languished
severals
gardez
languishes
renouncement
categories
recognizance
_pernicious_
_masculine_
omans
1669
sacring
vincentio
logistics
disordered
natus
natur
mediterranean
index
twine
gooky
twinn
unbated
shivers
twink
twins
proffer
surmis
_primitive_
_precede_
bird
mollis
cringing
led
lee
eminently
leg
len
spake
les
let
leu
lew
physiology
revile
pattle
unraised
insulin
residents
stephanie
hildesheim
acne
338
halfpenny
sire
complying
mariners
sirs
resurrection
cooperative
standing
cheered
recalling
archbishop
whipping
exsufflicate
ministers
levant
doubt
cheerer
_culture_
confiscate
occurred
labelled
sharply
pygmy
demerits
farmyard
onlooker
drily
rheims
insists
mammet
chamberlain
loathsomeness
drill
newts
choirs
bahrain
streamed
bent
pepin
benz
high
beckoned
bene
bend
blvd
benj
trumpet
portage
negation
reinstated
animal
luster
especial
tailors
blocks
aspiring
await
notebook
demonstrating
parmacity
efficiently
underbearing
messaline
untrimmed
pursuivant
nance
issn
prawns
issu
unstanched
_x_
allot
allow
chafts
alloy
austin
issy
unvaried
unmeriting
comme
_tells_
comma
thinning
omnes
operative
caffin
shudder
precaution
hobby
desirers
gard
_pre
designs
piecing
belch
runswick
billiard
kiss
liberia
comedy
irks
pulsidge
delightful
effuse
scants
graphs
scanty
borachio
joyed
decays
thirteen
dowerless
tolling
jethro
wander
sovereign
microscope
submerg
fatherland
venom
favours
cromwell
oblong
berrord
interactions
baa
incalculable
inhaling
loomed
surely
cordis
emboldens
chartreux
dismantled
linguist
spill
latches
splenitive
david
scoggin
davis
latched
spilt
endowments
blown
pines
owned
jesus
straining
owner
blows
summaries
cabbage
retourne
pined
legislative
sharon
underborne
exhal
percussion
mangold
iota
painful
adopts
malady
confectioner
penitential
rotunda
tuscan
coinage
steel
colleagues
buttocks
steed
tortured
jollity
colleagued
malpractice
punctured
tortures
torturer
steep
torrent
steer
cittern
revil
clearly
necessities
competency
documents
soak
latins
studying
patroness
adjunct
decomposing
bezonian
latina
necessitied
latino
competence
soar
brazil
szek
_glands_
carcasses
indurance
medal
abergavenny
ignited
gainsays
unseeingly
saltness
scrap
bikes
manchester
lloyd
fustilarian
illumine
hops
enamelled
softens
planted
suppos
georgium
molecules
maggots
bourbon
flinch
secretaries
hope
exchanged
insight
meditative
quartering
allons
derogately
exchanges
katharine
dardanius
dishearten
committees
reid
rein
temporarily
gaskis
vizarded
protectingly
tomyris
edition
slanted
subcommittee
_subtile_
incurable
partisan
injustice
fehemently
derogatory
magnifico_
dislik
vitamin
historians
restrictions
figured
drum
drug
apter
figures
volley
druv
pouncet
adjusted
ch
co
cn
cm
cl
cc
cb
ca
cg
cf
ce
cd
cz
crafted
modeling
cs
cr
allocated
cp
cw
cv
cu
judgest
mailto
uncorrected
wraiths
gondola
questionless
dazzling
taste
c_
hottest
ballast
tranio
horsemen
rioting
perfectest
roasting
ramston
ador
atlanta
gunpowder
saliences
toothless
installing
grinning
surveyors
ound
maud
maui
maul
eyeball
ripe
delaying
lush
neapolitan
lust
ripp
adsl
glared
waspish
concealing
incarnadine
romance
glares
soundness
inlaid
balm
ball
balk
bali
dusk
bale
bald
spenser
forecasts
iago
hangman
doct
dust
clotens
discounted
trudge
colour
harts
dispraisingly
command
maggot
bethump
glut
gulls
enmesh
glue
spinsters
afflicted
generous
clergyman
residential
skains
sickened
metheglins
innocents
taunt
famously
grovelled
smithsonian
hettin
corruptly
magnifi
bloomin
_condense_
crisp
onion
babylon
susceptibilities
unadvis
stagger
mhz
enpierced
replacement
indications
murk
habitat
concave
footage
murd
thief
acetous
ballot
transport
ballow
henchman
collaborative
disbelief
avoid
ether
noces
forgiven
expo
hoarded
stairway
ermengare
stags
overgo
arviragus
trouts
nabuchodonosor
stage
gained
repaired
sister
mawkin
commonplaces
gutenberg
angeles
foretold
seeds
gainer
seedy
comp
strode
diabolical
alliance
recognise
miscarried
lawlessly
commitment
dozmare
miscarries
swimmers
suborned
boisterously
housing
disapproval
verefore
slovakia
sanded
specimens
naturally
function
funnel
bums
storehouse
narvous
delivery
construction
delivers
discoverers
count
packard
official
smooth
reinforcement
undutiful
tanner
bearing
scept
shepherdes
recognize
entente_
irritation
dissemination
denote
barcelona
mushroom
variety
choristers
inexecrable
_oriens_
gallantly
lading
_amalgam_
oppression
missouri
francisca
baffling
bethrothed
unstooping
pacify
fundamentally
tanned
baynard
aetna
rigging
depravation
pension
rural
termless
buoy
consolidated
lidderdale
aviation
dist
oldest
_letter
agnize
ali
orpheus
restock
tarry
fireplaces
geology
blanket
distort
sellers
disobedient
wagons
adaptive
hatteras
bewildered
fogs
upload
relentlessly
undervalu
particularities
craveth
crumples
dwindled
deutsch
occasioned
established
mpeg
cressids
near
falconbridge
above
neat
cressida
counters
sinks
usurps
mooning
pluto
ningly
ragingly
pursuit
moroseness
celebration
studs
dizy
murders
rigorously
inception
smoky
usps
smoke
bettered
aka
diameter
secure
appelez
assyria
uncivil
cheats
thursday
appelee
glance
_written
palestinian
indians
chooser
chooses
sowden
knoll
indiana
antagonism
fractions
reign
it
continual
tariff
harnessing
droppeth
soils
grovel
pierc
groves
tinder
mechanic
spendthrift
stagnantly
piers
clinging
quiver
mercatante
serpent
possagno
in
ia
indies
indifferent
rareness
envenomed
grandjurors
debauchery
tobacconist
morbid
boats
ordinary
unwarily
unvisited
undeeded
troien
arsked
germaines
loach
oxides
chilled
receding
damoiselle
passado
greet
greek
green
brecknock
unkindest
greed
toddy
zed
devote
consent
greyness
hereford
mayor
somewhere
supplicant
denver
offic
dimity
precipitate
then
them
affected
seleucus
remission
fragment
thee
amenable
vegetable
sentimental
they
_population_
youngling
bavaria
nebuchadnezzar
classified
parthia
ersway
relished
mrna
behalfs
excavations
eave
councils
followest
transient
crimes
extincture
hurlyburly
hosted
crimea
flock
_know_
_oxide_
hostel
aimest
forty
vessels
strangers
sacramento
opportune
forth
sliding
exequies
laughest
lawless
lymoges
tial
putty
226
mutilate
indemnity
lavache
staggers
recovering
angl
bavin
staggery
festival
incorporated
baltic
placket
macdonwald
chopped
organize
cigarette
cochineal
blossomed
drones
trundling
expeckit
gooseberry
hearse
disgorged
stiffened
plentiful
airs
airt
airy
hearst
enhancing
automotive
tithe
bibble
glorified
tavern
binds
splendidly
languishment
solely
shoals
plantagenets
manner
vigorous
conversationally
sluggardiz
strength
_elastic_
magnus
chagrin
subduing
practices
babylonia
hawed
claims
puddin
nutritive
manifested
sub
florizel
leavening
accounted
calmness
sun
notion
renting
subtly
jourdain
untraded
musty
madeira
iron_
shrewsbury
yellowing
wrung
subtle
blotting
scrimers
resemblance
alluded
guidance
courtin
foison
cerberus
predecessor
do
dl
dm
dj
dk
dh
di
df
dg
dd
de
db
dc
yielded
frowning
bettre
dx
dy
dv
yielder
dt
du
dr
_annexed_
dp
handspike
replant
squadron
unprovident
triumphed
unmake
triumpher
depends
christian
mangoes
bicker
brewster
ensures
gentleman
unparallel
vulgarly
tainted
glansdale
props
deputies
_alpha_
infidel
buskin
bespoken
sickens
packages
muskos
cop
cos
cor
cot
cow
coy
cox
coz
rawly
erpicturing
cod
cog
requests
com
col
con
negotiation
eyesight
guil
beheaded
jays
heals
merchantibility
petty
buffets
chiders
chimneys
flexible
dozens
pyramus
entreatments
families
beastly
coherent
harboured
ordnance
physician
voluminous
formatting
abrupt
1842
getrude
voice
opt
fleance
discourses
discourser
strasba
audrey
penetrable
unfitting
hebrew
comparative
discoursed
infold
patent
punctuation
jerry
plated
corrigible
monarch
indictment
flatteries
unharmed
raid
blames
rail
evil
pubs
norwegian
rais
horum
faiths
greedily
kept
thy
thu
taint
tho
literatured
babel
presiding
the
camps
kinship
therewith
halloo
hostilius
halloa
repose
wasps
arpad
hallow
adding
hurtless
hills
flooring
compeers
gipes
hilly
passive
alchemy
spread
transformed
hillo
plasma
basset
ashore
capt
capp
caps
arab
cho
fioricet
mocker
barge
cape
korean
disadvantage
lily
grizzly
lapsed
grizzle
security
accuracy
antique
portuguese
sends
odours
_optical_
webs
productions
constables
skelter
sposin
purple
florence
comments
intendeth
devotedly
gastness
graduates
englishmen
graduated
jurors
dines
diner
impenetrable
theirs
caithness
dined
bearest
cherish
gingerbread
kyle
dilemma
mantle
pays
delighted
catechising
viewless
formidable
balanced
lewd
gatekeeper
wailed
undiscovered
unchanging
_do
fight
accordingly
dews
dewy
lanuvium
_statues_
sagging
priam
vitality
_narcotic_
reset
algiers
responding
dowry
veiled
inquir
unthinkable
manioc
generosity
vatican
rialto
mails
hotter
redime
inclusive
religiously
darting
evidence
manure
subsist
octavius
cacao
mold
mole
physical
disputable
weakened
handmade
interested
unwilling
truro
flay
guiltless
polite
mightily
funerals
bacchanals
tracked
castaway
cheated
boudoir
modules
together
cheater
reception
lyre
vampires
phosphorescence
fulcrum
baited
conspirers
_nature_
toothpick
grape
zone
flask
hums
hump
flash
humh
glad
lorship
explode
hume
feebly
protective
aldermen
woolly
liability
anonymous
blast
feeble
scandinavia
overshine
altering
auld
fragile
_analysis_
p
revolutionised
distasteful
revolution
niggardly
tartar
excrements
pabble
continence
scaffold
chronometer
riform
continency
satisfy
collateral
unsure
rubbers
apache
hoops
appears
change
nois
eke
trial
behav
_constructed_
matrimonial
retired
hiking
lending
committal
herbaceous
snowboard
retires
_susceptible_
illumination
rarely
whereunto
jan
undividable
senile
inquiringly
masturbating
live
turbo
selfsame
drabbing
plaything
entrance
credulity
towers
afore
denuded
mustn
clumps
payin
labeled
gathers
incidents
cochineals
lapis
breeds
spy
dedicated
_spontaneous_
fortuned
saith
december
subsidies
carroll
supremacy
fortunes
sheepcote
purity
spa
slackly
serum
wenches
productive
bankrupt
malevolence
ancientry
means
trophies
gimmers
criterion
allowable
entrench
bolds
ductile
staircase
penetrative
averted
brazen
court
flourish
compatibility
goal
remember
arabians
candles
explicit
ghz
rather
dishonoured
crept
offend
pendarves
aemilius
lordliness
urswick
embassies
tagged
hotly
indeed
forfeit
recanter
muliteus
goad
nitrogen
dagonet
lief
cold
cole
birds
_sublimation_
hafflin
acknowledge
selves
conquerors
backbitten
inflicted
window
suffocate
norway
feats
schnell
hals
halt
owedst
fling
_magnanimity_
flint
appoints
half
hall
halo
barrow
wont
streaks
servant
skilless
gba
wond
entirely
concerts
em
el
en
fired
ee
ed
eg
ef
ea
ec
goose
perdurable
fires
montacute
ey
ex
amsterdam
eu
et
ev
eq
ep
es
er
shown
opened
space
hastily
unmoan
opener
_whole_
receiving
shows
quare
weaknesses
procrus
bemoil
quart
rebel
inevitable
boulton
waxy
homily
unbrac
althaea
volquessen
engaol
palaces
saintlike
lighting
promotion
lambda
sprawling
benefited
wimpled
striking
chevalier
violences
impossible
forwarding
size
sheep
sheer
sheet
jugs
bookmark
carouses
moated
breed
callous
households
silenc
subdivision
friend
larder
courier
pelting
expanse
goodlier
larded
peck
rugged
anatomiz
lunched
overborne
optimism
plenteously
fruits
shady
sublime
lowrey
animis
rooks
surname
angel
rooky
correction
twinkled
13th
unbuild
_oscillation_
anger
anges
breakfast
mamillius
veteran
textiles
objective
burghers
verzeichnis
plainer
undertakings
vitruvio
brutus
greyish
garments
encased
sunset
patronizing
dispersed
abraham
engirt
foaming
octagonal
copyrighted
braggardism
boggle
paradoxes
ground
gnat
gnaw
ratio
enwraps
himmel
proportion
texture
developed
froward
_vegetable_
closeness
limbecks
callimachus
prides
fortifications
honours
appreciatively
outraged
medlar
verbosity
emboldened
breeches
_omnia
husband
bulgaria
_glutinous_
concert
chitopher
unmarried
famine
arithmetician
concern
tackling
atonements
seekers
ambo
moraler
dartford
justified
unsteered
fittin
unlocks
lineament
briskly
article
talented
comed
deputed
prorogued
comet
delete
comes
comer
characterization
dispatch
_minute_
moreover
_have_
punishes
zigzagged
porsche
lumpish
cupids
thumbzilla
dangers
exudes
sisterhood
exhaustion
superfine
wounds
observers
dwarfish
stems
sedition
developing
jointed
resoundingly
1642
_electro
stinkingly
hatchway
dregs
soil
treason_
soit
bias
embrace
bestial
heels
kenya
hent
multitudes
adversely
generously
media
document
finish
fruit
immobility
tradition
mentally
purer
theater
traps
trapp
allays
wedge
louring
luminous
_culinary_
echapper
tossing
speer
sulphate
civilized
writin
unprevented
touch
speed
untented
struct
benedicite
anceterer
desktop
nimbler
treatment
complements
mournful
momentum
real
hover
frown
read
specimen
digital
usefully
basest
quickness
mahommedan
sharded
detract
tenedos
execution
reap
hovel
rear
martyrs
_arise
pounds
postcard
suppliers
downward
xviii
homicides
brainish
servile
changeling
hacks
astronomer
duration
hisperia
peremptorily
putter
recorded
hepatitis
descents
limekilns
diffidences
recorder
felt
farthingales
tuition
credits
uncivilized
seducing
hectic
outsides
fondness
brighton
potosi
central
paints
unhearts
chok
chop
chor
coronal
greatly
venuto
protests
goethe
teeled
polyglot
foining
heated
operator
prepare
caitiffs
martlet
grange
stealth
valencia
immaculate
coloquintida
uproars
curiously
cottage
plood
hire
dominican
circulation
dominical
comics
bucket
wealthily
builders
codling
guildenstern
oxen
subdue
momentarily
ners
describe
moved
sales
salem
nero
mover
moves
antenna
administered
marvellously
storage
steeds
thither
sanguis
evenings
mathematics
abodements
surest
polar
coherence
mutability
desolation
eanlings
coverage
torcher
torches
mourned
mistakings
forswear
doubted
mourner
patchwork
strings
enlargeth
pointing
splitting
_adhesive_
bequeath
adhere
toasting
referring
reverend
candour
dinnertime
solicit
nodes
cdna
subtleties
mpg
precipices
vert
confidential
very
robes
mph
verb
vere
minded
verg
headgear
robed
gawded
finger
propinquity
misthought
_poles_
skim
vanquish
longfellow
skin
craning
bohea
bergamot
thehun
sould
conscience
witnessed
dribbling
witnesses
roofs
repugnant
quoit
answers
strond
strong
seely
ultra
colored
ahead
disclaimers
soldier
unplagu
interposes
interposer
toughness
impiety
_that_
hogs
slavish
unpleasantness
disloyalties
answered
vg
rockings
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
