manthan1412/air_touch/Block_diagram/Device_working_block_diagram.PNG

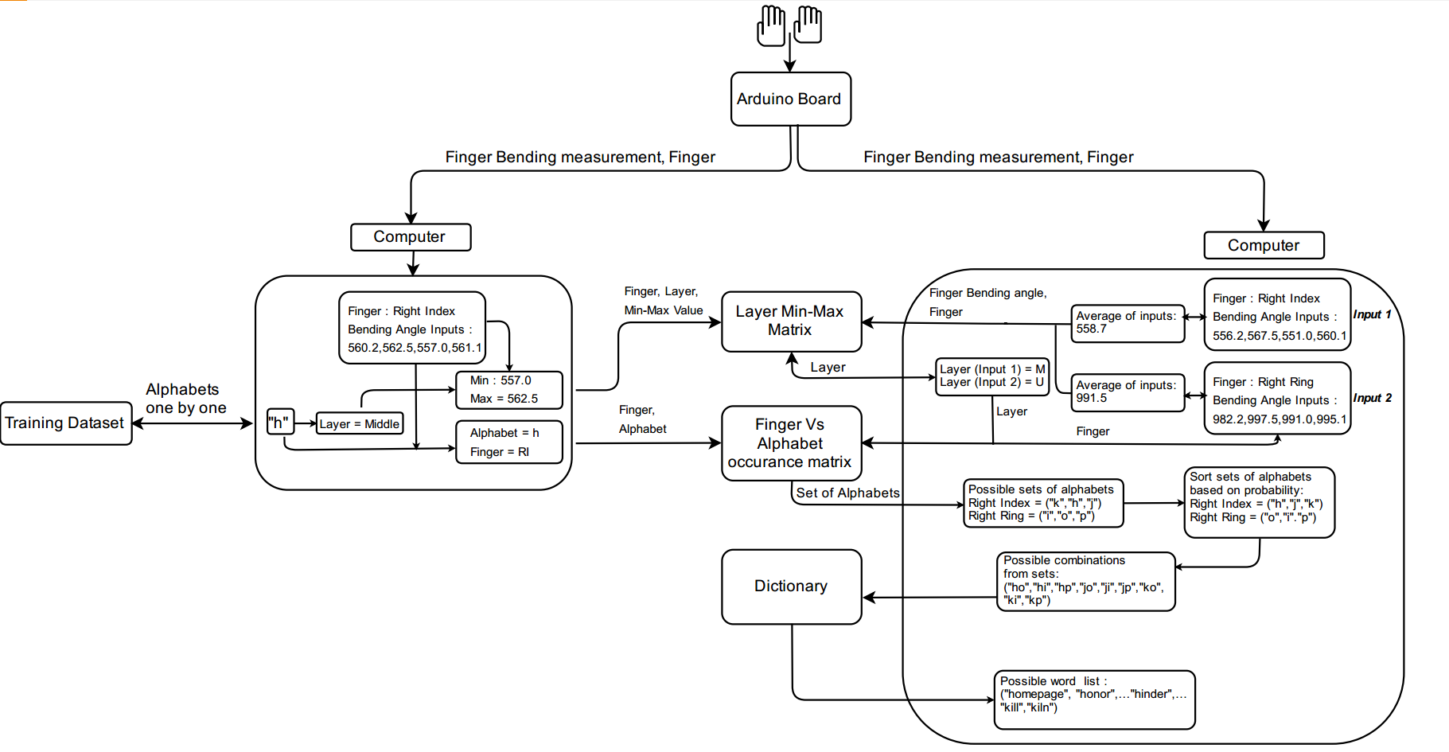
Block_diagram/Device_working_block_diagram.PNG
