manthan1412/air_touch/Keyboard Layout/Keyboard Layout.gif

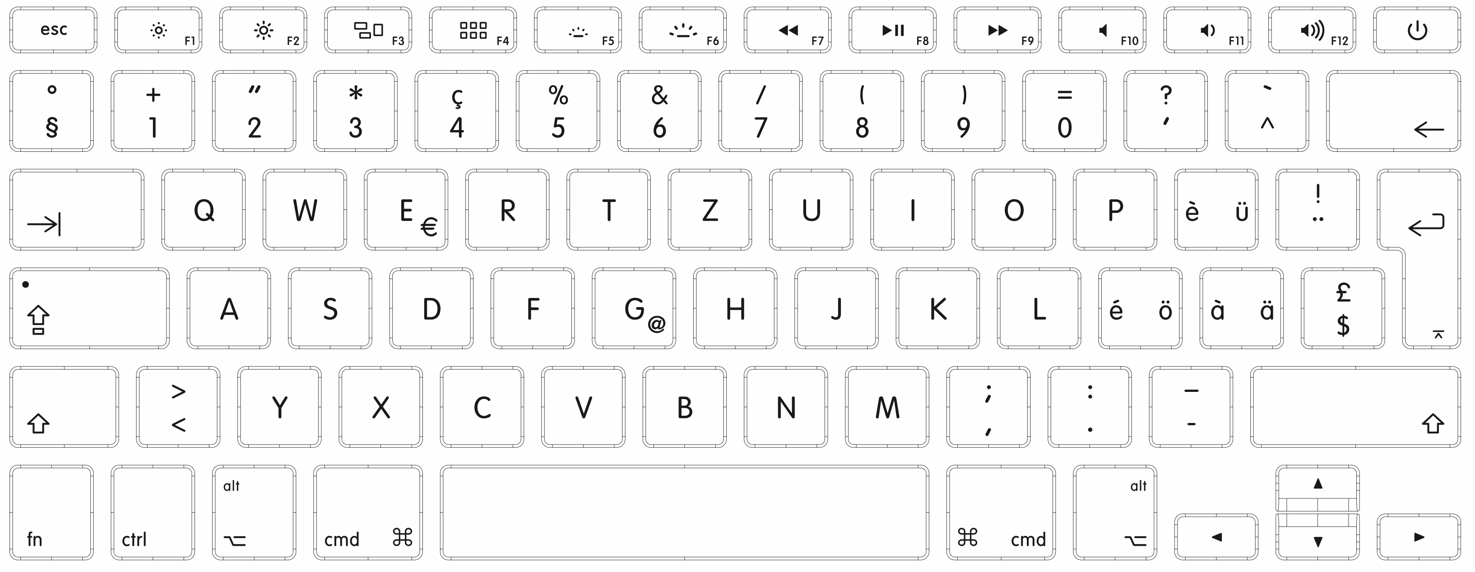
Keyboard Layout/Keyboard Layout.gif
