manthan1412/air_touch/Block_diagram/Device_working_block_diagram_0422.pdf

### Arduino Board

### Finger Bending measurement, Finger

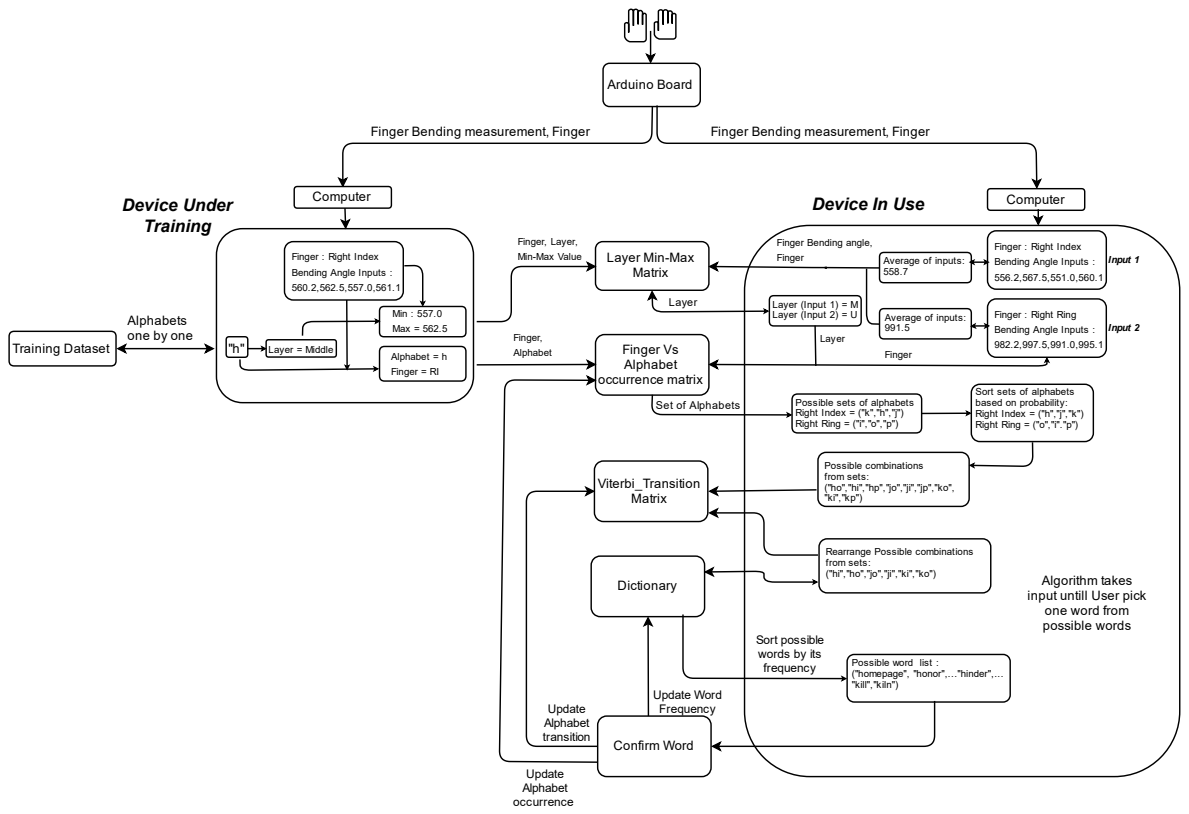
[picture p114: page 1]
Computer; Training Dataset; Finger Vs Alphabet occurrence matrix; Layer = Middle; Min : 557.0 Max = 562.5; Alphabet = h Finger = RI; Finger, Alphabet; Input 1; Input 2; Layer (Input 1) = M Layer (Input 2) = U; Dictionary; Layer; Finger; Confirm Word; Device Under Training; Update Word Frequency; Update Alphabet occurrence; Viterbi_Transition Matrix; Update Alphabet transition

Finger Bending measurement, Finger

Device In Use

Finger, Layer,
Min-Max Value

Finger Bending angle,
Finger

Layer Min-Max
Matrix

Finger : Right Index
Bending Angle Inputs :

Average of inputs:

Alphabets
one by one

Finger : Right Ring

Sort sets of alphabets
based on probability:
Right Index = ("h","j","k")
Right Ring = ("o","i"."p")

Set of Alphabets

Possible sets of alphabets
Right Index = ("k","h","j")
Right Ring = ("i","o","p")

Possible combinations
from sets:

Rearrange Possible combinations

Algorithm takes
input untill User pick
one word from
possible words

Sort possible
words by its
frequency

Possible word list :
("homepage", "honor",..."hinder",...
"kill","kiln")
