manthan1412/air_touch/(commit log)

2017-01-16 Training module started
    [prob_matrix.csv]
2017-03-08 Viterbi added
    [occurances.csv, probability.csv, viterbi_probability.csv]
2017-04-09 Word Database changed
    [occurances.csv]
2017-04-09 layer lmit updated
    [layer_limit.csv, occurances.csv]
2017-04-17 Viterbi added to main.py
    [probability.csv, viterbi_probability.csv]
2017-04-20 added new words
    [probability.csv, viterbi_probability.csv]
2017-05-11 Report Updated
    [layer_limit.csv, occurances.csv]
2017-05-19 Arduino code and report updated
2017-05-22 Two distance word correction added
    [TRANSITION MATRIX.xlsx, layer_limit.csv, occurances.csv, occurrences.csv, prob_matrix.csv, probability.csv, viterbi_probability.csv]
2017-05-23 word validation and letter backspace functionality added.
    [TRANSITION MATRIX.xlsx, layer_limit.csv, occurances.csv, occurrences.csv, prob_matrix.csv]
2017-05-24 finger record and word sorting functionality added
2017-05-24 tried to solve issue, is nothing has been typed and delete or backspace command passes. Need to update in predict fun.
    [main.py]
2017-05-24 Dictionary with frequency added
    [dictionary.csv]
2017-05-24 Bug fixed for empty letter_buf
    [main.py]
2017-05-24 Word selection functionality added
    [probability.csv, viterbi_probability.csv]
2017-05-27 Arduino code updated for thumb
2017-05-30 Some good reading recorded but occurances were very low.
    [TRANSITION MATRIX.xlsx, dictionary.csv, layer_limit.csv, occurances.csv, occurrences.csv, prob_matrix.csv, probability.csv, viterbi_probability.csv]
2017-05-31 multi layer functinality added, dictionary updated,
    [TRANSITION MATRIX.xlsx, dictionary.csv, layer_limit.csv, occurances.csv, occurrences.csv, prob_matrix.csv, probability.csv, viterbi_probability.csv]
2017-06-01 Dictionary Update, alphabet occurrences added, tested for several words.
    Dictionary.py removes duplicate entries.
    [dictionary.csv, layer_limit.csv, occurances.csv, occurrences.csv, viterbi_probability.csv]
2017-06-09 Report Updated and to clean print log small modification has been done in main file.
    [dictionary.csv, occurrences.csv]
2017-06-19 Updates in report related files
    [dictionary.csv, occurrences.csv]
